xwj95/Atom/report/technical/src/package.tex

\usepackage{CJK}						%中日韩三国文字包
\usepackage{indentfirst}				%首段缩进包
\usepackage{amssymb}					%数学符号包
\usepackage{mathpazo}					%正文和数学字体包
\usepackage{geometry}					%页面设置包
\usepackage{graphicx}					%图片包
\usepackage{multirow}					%表格包
\usepackage{float}						%浮动包
\usepackage{tikz}						%流程图包
\usepackage{enumerate}					%标签包
\usepackage{cite}						%引用包
\usepackage[CJKbookmarks=true, colorlinks, linkcolor=black, anchorcolor=blue, citecolor=green]{hyperref}			%超链接包
\usepackage{longtable}					%长表格包

\setcounter{tocdepth}{5}
\setcounter{secnumdepth}{5}

\geometry{left=3cm, right=2.5cm, top=2.5cm, bottom=2.5cm}

\usetikzlibrary{shapes.geometric, arrows}

\renewcommand\arraystretch{1.5}
