xwj95/Atom/report/requirement/src/figure.tex

图片首先要转换为eps格式（请自行在网上找eps转换器）

 %中间的方括号用于设定图片大小，可选，大括号里是图片名字，图片大小除了用scale决定缩放比之外还可以通过width=1cm,height=2cm来指定规定大小，单位可以使用px,cm,inch等等

图片要放在同一目录下
