xwj95/Atom/report/requirement/src/table.tex

\clearpage

\begin{table}
\begin{tabular}{|c|c|c|c|c|c|c|c|c|c|c|c|c|c|c|c|c|}
\hline
\multirow{2}{*}{二进制（高位）} &
31&30&29&28&27&26&25&24&23&22&21&20&19&18&17&16\\
\cline{2-17}
&0&0&1&0&0&1&
\multicolumn{5}{c|}{rs}&
\multicolumn{5}{c|}{rt}\\
\hline
\multirow{2}{*}{二进制（低位）} &
15&14&13&12&11&10&9&8&7&6&5&4&3&2&1&0\\
\cline{2-17}
&
\multicolumn{16}{c|}{immediate}\\
\hline
MIPS语言&
\multicolumn{16}{l|}{ADDIU rt is immediate}\\
\hline
指令功能&
\multicolumn{16}{l|}{R[t] $\Leftarrow$ R[s] + Sign-extend(immediate)}\\
\hline
功能说明&
\multicolumn{16}{l|}{对立即数进行符号扩展后与寄存器rs的值求和，结果保存到寄存器rt中}\\
\hline
\end{tabular}
\end{table}

\begin{table}

\begin{tabular}{|c|c|c|c|c|c|c|c|c|c|c|c|c|c|c|c|c|}
\hline
\multirow{2}{*}{二进制（高位）} &
31&30&29&28&27&26&25&24&23&22&21&20&19&18&17&16\\
\cline{2-17}
&0&0&0&0&0&0&
\multicolumn{5}{c|}{rs}&
\multicolumn{5}{c|}{rt}\\
\hline
\multirow{2}{*}{二进制（低位）} &
15&14&13&12&11&10&9&8&7&6&5&4&3&2&1&0\\
\cline{2-17}
&
\multicolumn{5}{c|}{rd}&
0&0&0&0&0&1&0&0&0&0&1\\
\hline
MIPS语言&
\multicolumn{16}{l|}{ADDU rd rs rt}\\
\hline
指令功能&
\multicolumn{16}{l|}{R[d] $\Leftarrow$ R[s] + R[t]}\\
\hline
功能说明&
\multicolumn{16}{l|}{将寄存器rs与寄存器rt的值求和，结果保存到寄存器rd中}\\
\hline
\end{tabular}
\end{table}
\begin{table}
\begin{tabular}{|c|c|c|c|c|c|c|c|c|c|c|c|c|c|c|c|c|}
\hline
\multirow{2}{*}{二进制（高位）} &
31&30&29&28&27&26&25&24&23&22&21&20&19&18&17&16\\
\cline{2-17}
&0&0&0&0&0&0&
\multicolumn{5}{c|}{rs}&
\multicolumn{5}{c|}{rt}\\
\hline
\multirow{2}{*}{二进制（低位）} &
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
\cline{2-17}
&
\multicolumn{5}{c|}{rd} &
0&0&0&0&0&
0&0&0&0&0&
0\\
\hline
MIPS语言&
\multicolumn{16}{l|}{MFC0 rt rd}\\
\hline
指令功能&
\multicolumn{16}{l|}{R[t] $\Leftarrow$ CP0[R[d]]}\\
\hline
功能说明&
\multicolumn{16}{l|}{将协处理器0中的rd寄存器的值保存到rt寄存器中}\\
\hline
\end{tabular}
\end{table}

\begin{table}
\begin{tabular}{|c|c|c|c|c|c|c|c|c|c|c|c|c|c|c|c|c|}
\hline
\multirow{2}{*}{二进制（高位）} &
31&30&29&28&27&26&25&24&23&22&21&20&19&18&17&16\\
\cline{2-17}
&
0&1&0&0&0&
0&0&0&1&0&
0&
\multicolumn{5}{c|}{rt}\\
\hline
\multirow{2}{*}{二进制（低位）} &
15&14&13&12&11&10&9&8&7&6&5&4&3&2&1&0\\
\cline{2-17}
&
\multicolumn{5}{c|}{rd} &
0&0&0&0&0&
0&0&0&0&0&
0\\
\hline
MIPS语言&
\multicolumn{16}{l|}{MTC0 rd rt}\\
\hline
指令功能&
\multicolumn{16}{l|}{CP0[R[d]] $\Leftarrow$ R[t]}\\
\hline
功能说明&
\multicolumn{16}{l|}{将寄存器rt的值保存到协处理器0中的rd寄存器中}\\
\hline
\end{tabular}
\end{table}

\begin{table}
\begin{tabular}{|c|c|c|c|c|c|c|c|c|c|c|c|c|c|c|c|c|}
\hline
\multirow{2}{*}{二进制（高位）} &
31&30&29&28&27&26&25&24&23&22&21&20&19&18&17&16\\
\cline{2-17}
&
0&1&0&0&0&
0&1&0&0&0&
0&0&0&0&0&
0\\
\hline
\multirow{2}{*}{二进制（低位）} &
15&14&13&12&11&10&9&8&7&6&5&4&3&2&1&0\\
\cline{2-17}
&
0&0&0&0&0&
0&0&0&0&0&
0&0&0&0&1&
0\\
\hline
MIPS语言&
\multicolumn{16}{l|}{TLBWI}\\
\hline
指令功能&
\multicolumn{16}{l|}{R[d] $\Leftarrow$ R[t] $\ll$ R[s]}\\
\hline
功能说明&
\multicolumn{16}{l|}{写索引TLB项}\\
\hline
\end{tabular}
\end{table}

\begin{table}
\begin{tabular}{|c|c|c|c|c|c|c|c|c|c|c|c|c|c|c|c|c|}
\hline
\multirow{2}{*}{二进制（高位）} &
31&30&29&28&27&26&25&24&23&22&21&20&19&18&17&16\\
\cline{2-17}
&
1&0&0&1&0&
1&
\multicolumn{5}{c|}{rs}&
\multicolumn{5}{c|}{rt}\\
\hline
\multirow{2}{*}{二进制（低位）} &
15&14&13&12&11&10&9&8&7&6&5&4&3&2&1&0\\
\cline{2-17}
&
\multicolumn{16}{c|}{immediate}\\
\hline
MIPS语言&
\multicolumn{16}{l|}{LHU rt rs immediate}\\
\hline
指令功能&
\multicolumn{16}{l|}{R[t] $\Leftarrow$ Zero-extend(MEM$\_$HALFWORD[R[s] + Sign-extend(immediate)])}\\
\hline
\multirow{2}{*}{功能说明}&
\multicolumn{16}{l|}{将寄存器rt中的值与立即数immediate符号扩展后相加所得地址中的低两个}\\
&\multicolumn{16}{l|}{字节取出来零扩展后保存在寄存器rt中}\\
\hline
\end{tabular}
\end{table}
