xwj95/Atom/report/technical/src/title.tex

\title{32位MIPS综合实验设计文档}		%标题
\author{原子小组}						%作者
\maketitle							%显示标题、作者和日期
\tableofcontents					%目录
