xwj95/Atom/report/requirement/src/part5.tex

\section{附录}
\subsection{指令系统}
\input{table.tex}
