xwj95/Atom/report/requirement/requirement.pdf

# 32位MIPS综合实验需求文档

### 原子小组

### January 1, 2016

目 | 录
1 引言 | 2
2 功能需求 | 4
3 性能需求 | 13
4 运行环境需求 | 13
5 附录 | 14

## 1 引言

### 1.1 编写目的

撰写本篇需求文档的目的如下：

1. 明确项目需求，对该系统进行一个能够达成一致认可的描述，明确需要完成的功能；
2. 明确开发资源与项目目标；
3. 控制整个开发过程，作为开发手册的一部分，降低开发中小组讨论的成本。

文档预期读者包括开发人员、任务提出者及其他使用该资源的用户。

### 1.2 背景

本项目的系统名称为32位MIPS处理器。
本项目任务由计算机组成原理课程刘卫东老师、李山山老师和软件工程课程白晓颖老师共同提出。 承担本项目的开发者为计33班的徐炜杰、王楠和黄欢。此外还受到了刘卫东、白晓颖、李山山三位老 师的指导和王钧奕、张乐、刘亚宁三位助教的帮助。

### 1.3 定义

本段中给出了需求文档中对于一些术语的基本定义，具体如下。

表 1: 定义列表
术语 | 描述
RISC | Reduced Instruction Set Computer的缩写，指精简CPU指令集
MIPS | Microprocessor without Interlocked piped stages的缩写，指无内部互锁流水级的微 处理器，为一种典型RISC指令集
CPU | 中央处理器，为本项目的最终目标
CP0 | 系统控制协处理器，是CPU和操作系统交互的窗口；CPU通过CP0向操作系统传递运 行信息和异常信息等，而操作系统则通过操作CP0设置硬件的运行状态
MMU | 内存管理单元，负责对虚拟地址进行映射，并总管访问各种存储器和输入输出接口的 功能
TLB | 传输后备缓冲器（快表），即页表的高速缓存，用于加快地址转换。本项目需对内存 进行分页管理，即虚拟地址通过页表映射得到物理地址。
ALU | 算术逻辑单元
RAM | 存储程序的硬件，断电不保存信息，速度较快，常用于电脑主存储器
ROM | 存储程序的硬件，断电可保存信息
Flash | 存储程序的硬件，断电可保存信息，实验中用作硬盘
BIOS | 主板上的启动程序，负责初始化硬件引导操作系统
BootLoader | 由BIOS启动的一段特殊程序，用于将操作系统从Flash中加载到内存中，并且跳转到 开始地址执行
Controller | CPU模块之一，根据指令和硬件反馈信息给出控制信号，控制各个部件和整个CPU 的运行
组合逻辑元件 | 与运行时钟无关的元件，某一时刻的输出只取决于当前输入
时序逻辑元件 | 根据系统的时钟信号，在时钟的上升沿工作的元件。某一时刻的稳定输出由当前输入 和历史状态共同决定。注意组合逻辑元件和时序逻辑元件往往没有明确的分界；一个 寄存器往往仅在上升沿写入，但却随时按照组合逻辑方式将其内容进行输出

### 1.4 参考资料

1. 实验指导文档
2. OSLab实验参考文档
3. 贾开, 周昕宇, 李铁铮, 等. 计算机组成原理综合实验报告
4. 逆光组. 清华大学计算机组成原理32位Mips CPU教程
5. 刘卫东, 李山山, 宋佳兴, 等. 计算机硬件系统实验教程[M]. 清华大学出版社, 2013.
6. 帕特森, 亨尼斯, 康继昌, 等. 计算机组成与设计: 硬件/软件接口[M]. 机械工业出版社, 2012.
7. Sweetman D. See MIPS run[M]. Morgan Kaufmann, 2010.
8. 雷思磊. 自己动手写CPU[M]. 电子工业出版社, 2014.

## 2 功能需求

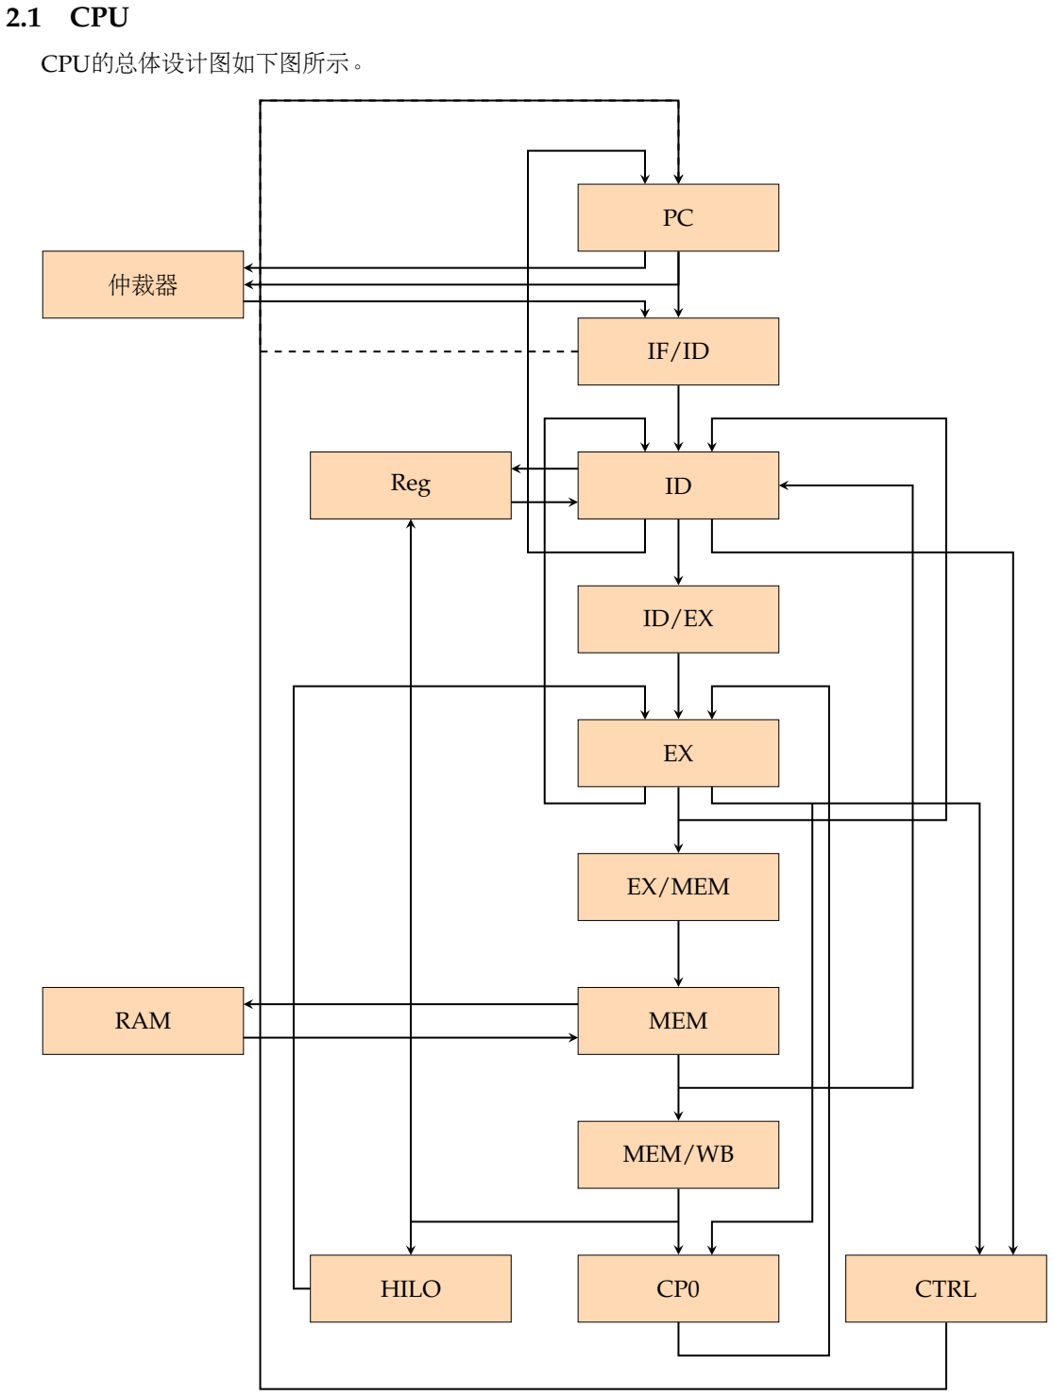
[picture p13: figure]
2.1 CPU; CPU的总体设计图如下图所示。; 仲裁器; Reg; EX/MEM; RAM; MEM; MEM/WB; HILO; CTRL

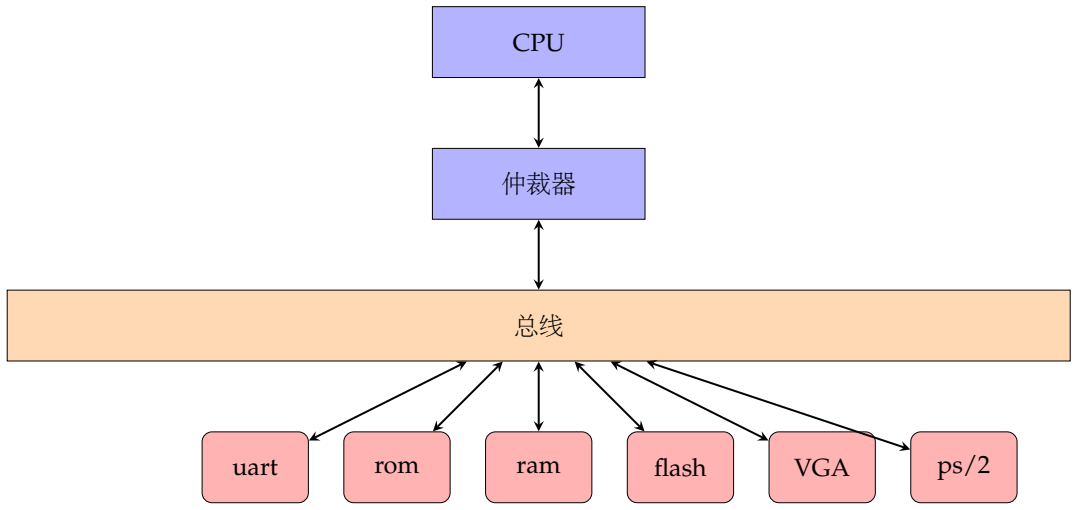
[picture p14: figure]
CPU; 仲裁器; uart; rom; ram; flash; VGA

### 2.1.1 ALU

算术逻辑单元负责实现双输入的算术、逻辑和移位运算功能，其中包括乘法运算。 算术逻辑单元的输入端为两个32位整数和一个8位操作码，输出端为32位整数（乘法运算除外），并 给出相应的标志位。
由于算术逻辑单元需要实现的运算种类较多，我们在此不做列举。

### 2.1.2 乘法器

乘法器负责实现乘法功能，输入为两个32位整数，输出为一个64位整数，分别存放在LO和HI两 个32位寄存器中。
乘法运算采用Verilog语言提供的乘法运算符实现。我们没有将乘法器作为一个独立的元件来实现，而 是在ALU中加入乘法的操作码，将乘法器并入算术逻辑单元实现。

### 2.1.3 寄存器堆

寄存器堆负责实现通用寄存器的读写和在数据通路中的控制，在流水线译码阶段读取一个或两个通用 寄存器的数据（组合逻辑电路），并在流水线写回阶段将结果写入通用寄存器（时序逻辑电路）。 32位MIPS架构需要实现32个32位通用寄存器，寄存器堆采用FPGA的逻辑单元来实现数据的存储，因 此读写速度比内存快。

### 2.1.4 CP0

32位MIPS架构支持4个协处理器，本次实验需要实现CP0协处理器。CP0协处理器可以实现对TLB、MMU及 异常处理的管理机制。
下表列出了CP0的寄存器及其功能，这里我们只给出必须实现的11个寄存器。

编号 | 寄存器名称 | 寄存器功能
0 | Index | 用于TLBWI指令访问TLB入口的索引序号
2 | EntryLo0 | 作为TLBWI及其他TLB指令接口，管理偶数页入口
3 | EntryLo1 | 作为TLBWI及其他TLB指令接口，管理奇数页入口
9 | BadVAddr | 捕捉最近一次地址错误或TLB异常（重填、失效、修改）时的虚拟地址
10 | Count | 每隔一个时钟增加1，用作计数器，并可使能控制
11 | EntryHi | TLB异常时，系统将虚拟地址部分写入EntryHi寄存器中用于TLB匹配信息
12 | Compare | 保持一定值，当Count值与Compare相等时，SI TimerInt引脚变高电平直到有数

值写入Compare，用于定时中断

13 | Status | 表示处理器的操作模式、中断使能及诊断状态
15 | Cause | 记录最近一次异常的原因，控制软件中断请求以及中断处理派分的向量
16 | EPC | 存储异常处理之后程序恢复执行的地址
18 | EBase | 识别多处理器系统中不同的处理器异常向量的基地址
(1) Index寄存器 Index寄存器是一个32位读/写寄存器，可用于TLBP、TLBR和TLBWI指令访问TLB入口 的索引序号。
Index区域的大小根据具体实现方式随TLB的入口个数而定。对于基于TLB的内存管理单元MMU来 说，该区域的最小值为dlog2(TLBEntries)e。 如果一个写入Index寄存器的值大于等于TLB入口数，则该处理器的操作是未定义的。 该寄存器仅对TLB有效。
31 | 30 | 6 | 5 | 0
P | 0 | Index
区域 | 描述 | 读/写 | 重置状态
名称 | 比特
P | 31 | 检测故障。当先前的TLBProbe（TLBP）指令没有在TLB中寻 得匹配时，硬件会将其置为1。 | R/W | 未定义
0 | 30:6 | 必须写为0；读取时返回0. | 0 | 0
Index | 5:0 | TLB入口的索引值，收到TLBRead和TLBWrite指令影响。 对于16或32个入口的TLB，如果索引指向一个不存在的入口， 则该行为是未定义的。 | R/W | 未定义
(2) EntryLo1/EntryLo0寄存器 这对EntryLo寄存器的作用等同于TLB、TLBR、TLBWI和TLBWR指令间 的接口。对基于TLB的MMU而言，EntryLo0管理偶数页的入口，EntryLo1管理奇数页的入口。如果 出现了地址错误，TLB失效，TLB修改或是TLB重填异常的行为，那么EntryLo0和EntryLo1寄存器的 内容将会成为未定义的。只有当基于TLB的存储管理单元存在时，这些寄存器才有效。
31 | 30 | 29 | 26 | 25 | 6 | 5 | 3 | 2 | 1 | 0
R | O | PFN | C | D | V | G

区域 | 描述 | 读/写 | 重置状态
名称 | 比特
R | 31:30 | 保留区域。写入时应被忽略；读取时返回0. | R | 0
O | 29:26 | 在一般情况下，这4个位为PFN的一部分。但由 于24k仅支持32位的物理地址，PFN仅有20位 的位宽，所以，该寄存器的29:26位强制写入0. | R | 0
PFN | 25:6 | 页帧号：有助于物理地址高位的定义。PFN区域 对应了物理地址的31 12位。 | R/W | 未定义
C | 5:3 | 页面一致性属性。 | R/W | 未定义
D | 2 | 已使用或写使能位：表示了该页面已经被写入，并且 /或者是可写入的。如果D=1，则允许写入该页；如果 D=0，则不允许写入该页，否则会引起TLB修改异常。 | R/W | 未定义
V | 1 | 有效位：指明当前TLB入口是否有效，即虚拟页面映 射是否有效。如果该位为1，那么允许进入该页；如 果V=1，则允许访问该页；如果V=0，访问该页会引 起TLB无效异常。 | R/W | 未定义
G | 0 | 全局位：在对TLB入口进行写操作时，EntryLo0和 EntryLo1寄存器中的G位与运算的结果作为TLB入 口的G位。如果TLB入口的G位时1，ASID比较将在 TLB匹配中被忽略掉。在对TLB入口进行读操作时， EntryLo0和EntryLo1的G位都反映了TLB的G位的状态。 | R/W | 未定义
C[5:3]值 | 缓存一致性属性
0 | 可缓存、非一致性、写通、无写分配
1 | 保留
2 | 不可缓存
3 | 缓存可、非一致性、写回、写分配
4,5,6 | 保留
7 | 无缓存加速
(3) EntryHi寄存器 EntryHi寄存器包含了用于TLB读、写和访问操作的虚拟地址匹配信息。当TLB异常 （TLB Refill，TLB Invalid或TLB Modified）发生时，系统将虚拟地址的[31:13]位写入EntryHi寄存 器的VPN2区域。TLBR指令将选中的TLB入口相应的区域写入EntryHi寄存器。软件（通常是操作系 统）将当前地址空间标识符写入ASID区域，该区域在TLB比较过程中用于确定TLB是否可以匹配。 由于ASID区域被TLBR指令重填覆盖了，软件必须保存和重新存储有关TLBR使用的ASID的值。这在 发生TLB失效和TLB修改异常时，以及在其它存储管理软件中尤为重要。 在发生了地址错误的异常后，EntryHi寄存器的VPN2区域将成为未定义的，并且该区域可能在 发生地址错误异常的过程中被硬件修改。EntryHi寄存器的软件写操作（通过MTC0）不会导

致BadVAddr和Context寄存器中的地址相关区域发生隐式的写入（implicit write）。

31 | 13 | 12 | 8 | 7 | 0
VPN2 | 0 | ASID
区域 | 描述 | 读/写 | 重置状态
名称 | 比特
VPN2 | 31..13 | 虚地址（虚拟页面数目的一半）的VA31..13。在TLB异常 或TLB进行读取时，该区域被硬件写入；在TLB写之前， 该区域被软件写入。 | R/W | 未定义
0 | 12..8 | 必须写为0；在读取时返回0. | 0 | 0
ASID | 7..0 | 地址空间标识符。在TLB读取时，该区域由硬件写入；通过 软件写该区域，可以为TLB写操作建立当前的ASID值，这 样可以避免对TLB的访问匹配所有TLB入口的ASID值。 | R/W | 未定义

该寄存器仅对TLB有效。

(4) Status寄存器 Status寄存器是一个读/写寄存器，可以表示处理器的操作模式、中断使能以及诊断状 态。该寄存器的区域联合作用，可以创建处理器的工作模式。 中断使能：当以下所有条件成立时启用中断：
Status[0]:IE = 1
Status[0]:EXL = 0
Status[0]:ERL = 0
额外的：Debug[0]:DM = 0
当这些条件都符合时，设置IM（Status[16:9]）位和IE位可以使能中断。 EXL与ERL任一位置1都可使系统进入Kernel模式，否则为User模式。
(5) Cause寄存器 Cause寄存器主要记录最近一次异常的原因，也控制软件中断请求以及中断处理派分的 向量。除了IP1..0、DC、IV和WP区域，Cause寄存器中其它的所有区域都是只读的。第二版架构在 外部中断控制器（EIC）的中断模式下，增加了可选项。在这个模式下，IP7..2表示请求中断优先级 （RIPL）。
Cause[6:2]表示ExcCode，即异常号。
(6) Ebase寄存器 EBase寄存器是一个读/写寄存器，包含了在StatusBEV为0时所使用的异常向量的基地 址及一个只读CPU号，该CPU号可以被软件用来区分多处理器系统中不同的处理器。 EBase寄存器使软件能在多处理器系统中识别特定的处理器，并允许每个处理器的异常向量可以不 同，特别是对由多种处理器组成的系统。当StatusBEV为0时，EBase寄存器的位31:12由0构成，形成 异常向量的基地址。当StatusBEV为1时，或在任何EJTAG调试异常的情况下，异常向量的基地址由 固定的缺省值确定。
EBase寄存器的位31:30固定为2#10，从而强制异常基地址在kseg0或kseg1的无映射的虚拟地址段中。 在缓存错误异常中，异常基地址的位29将被强制置为1，从而使异常处理器从无缓存的kseg1段开 始执行。如果需要改变异常基地址寄存器的值，则操作必须在StatusBEV为1的情况下进行。如果 在StatusBEV为0时，在异常基地址区域写入了一个不同的值，处理器的操作将成为未定义的。 将位31:12与异常基地址区域相结合，可允许将异常向量的基地址置于任何4KB字节大小的页面的边界 上。

31 | 30 | 29 | 12 | 11 | 10 | 9 | 0
1 | 0 | Exception Base | 0 | CPUNum
区域 | 描述 | 读/写 | 重置状态
名称 | 比特
1 | 31 | 在写入时，该位被忽略；在读取时，返回0. | R | 1
Exception | 29:12 | 与位31:30结合，该区域在StatusSEV为0时，指定了 异常的基地址。 | R/W | 0
CPUNum | 9:0 | 该区域包含了一个标识符，它对多处理器系统的每个 CPU都是唯一的。软件可以用此来判断它运行的位置。 这个区域的值由连接到内核的SI CPUNum[9 : 0]静态 输入管脚设置。 | R | 外部设置
0 | 30, 11:10 | 必须写为0；在读取时返回0. | 0 | 0

通过调用MFC0，MTC0指令，CP0提供了统一的对外接口以完成对寄存器组的访问。

实现步骤：

(1) 选择要实现的CP0寄存器，可考虑推荐实现的寄存器或自行决定额外寄存器实现。
(2) 按照CP0寄存器的功能分别在CPU的不同模块完成各寄存器的赋值。
(a) 在译码、运算及访存阶段发生地址错误时将错误地址赋值给BadVAddr
(b) 异常处理开始时，若为TLB异常，则将错误地址高20位赋值给EntryHi高20位
(c) 异常处理开始时，将Status[1]赋值为1；在执行ERET指令时将Status[1]赋值为0
(d) 异常处理开始时，将Cause[6:2]赋值为异常号
(e) 异常处理开始时，将EPC赋值为Victim指令地址
(f) 每个周期，Count加1
(g) 其他写操作由软件完成
(3) 实现MFC0，MTC0指令访问CP0寄存器的功能。
(4) 通过各寄存器值控制相应功能。

### 2.1.5 异常中断处理

本次实验要求实现精确异常处理，即确定异常发生的位置，确保该指令前的指令全部执行完毕，并将 该指令后的指令从流水线上擦除。
以下是一些可能用到的中断和异常的情况。

异常号 | 异常名 | 描述
0 | Interrupt | 外部中断、异步发生，由硬件引起
1 | TLB Modified | 内存修改异常，发生在Memory阶段
2 | TLBL | 读未在TLB中映射的内存地址触发的异常
3 | TLBS | 写未在TLB中映射的内存地址触发的异常
4 | ADEL | 读访问一个非对齐地址触发的异常
5 | ADES | 写访问一个非对齐地址触发的异常
8 | SYSCALL | 系统调用
10 | RI | 执行未定义指令异常
11 | Co-Processor Unavailable | 试图访问不存在的协处理器异常
23 | Watch | Watch寄存器监控异常

下表列出可能用到的中断号。

| 中断号 | 设备
| 0 | 系统计时器
| 1 | 键盘
| 3 | 通讯端口COM2
| 4 | 通讯端口COM1

中断/异常处理的一般流程如下：

(1) 保存中断信息，主要是EPC，BadVaddr，Status，Cause等寄存器的信息 EPC:存储异常处理之后程序恢复执行的地址。对于一般异常，当前发生错误的指令地址即 为EPC应当保存的地址；而对于硬件中断，由于是异步产生则可以任意设定一条并未执行完成的指令 地址保存，但在进入下一步处理之前，该指令前的指令都应当被执行完。 BadVAddr：捕捉最近一次地址错误或TLB异常（重填、失效、修改）时的虚拟地址。 Status：将EXL位置为1，进入kernel模式进行中断处理。
Cause：记录下异常号。
EntryHi：TLB异常时，记录下BadVAddr的部分高位。
(2) 根据Cause中的异常号跳转到相应的异常处理函数入口
(3) 中断处理
(4) 通过调用ERET指令恢复现场，返回EPC所存地址执行并且将Status中的EXL重置为0表示进入user模 式。

实现步骤：

(1) 在可能发生异常的位置实现对异常的记录。
(a) 访存时可能发生ADEL，ADES，TLBM，TLBL，TLBS，Watch异常
(b) 译码后可能发生RI，SYSCALL，Co-ProcessorU异常

(2) 实现对中断的记录。
(a) 硬件产生中断时将信息写入CP0寄存器
(3) 根据异常记录信息判断是否产生异常。
(4) 进入异常处理流程。

### 2.1.6 MMU

内存管理单元负责实现虚拟地址转换到物理地址，再访问相应元件读取或写入数据的全过程，并实现 内核态与用户态的区分。同时MMU还需要集成TLB模块，并实现相应的TLB异常处理。

### 2.1.6.1 物理地址划分

物理地址范围 | 设备 | 说明
[0x00000000, 0x007FFFFF] | RAM | 共8MB
[0x1FC00000, 0x1FC00FFF] 引导ROM | 共4KB
[0x1E000000, 0x1EFFFFFF] flash | 地址空间共16MB，但对于32位字，只有低16位有效
[0x1A000000, 0x1A096000] | VGA
0x1FD003F8 | 串口数据
0x1FD003FC | 串口状态
0x1FD00400 | 数码管
0x0F000000 | 键盘码

### 2.1.6.2 虚拟地址划分

虚拟地址范围 | 名称 | 权限 | MMU | 物理地址范围
[0x00000000, 0x7FFFFFFF] | kuseg | 内核/用户 | 是 | -
[0x80000000, 0x9FFFFFFF] | kseg0 | 内核 | 否 | [0x00000000, 0x1FFFFFFF]
[0xA0000000, 0xBFFFFFFF] kseg1 | 内核 | 否 | [0x00000000, 0x1FFFFFFF]
[0xC0000000, 0xFFFFFFFF] | kseg2 | 内核 | 是 | -

### 2.1.6.3 TLB

虚拟地址到物理地址的转换是通过查找页表来实现的，为了加速查询过程，CPU对页表进行缓存。如 果虚拟地址在页表中没有找到相应的映射，将产生缺页异常，由操作系统将对应的页表项加入缓存，并 继续进行访问操作。
本实验中硬件需要实现一组寄存器来存储页表的缓存，支持TLBWI语句，并和CP0协处理器配合工 作，页表的管理和异常处理等则由软件实现。
TLB共有16个表项，每个表项有64位长，每项可以存储两个物理页，因此总共可以存储32个页。 每次页表项更新时，页表信息被存放在如下寄存器中：目录为INDEX [3 : 0]，对应的每个表项入口为 {EntryHi [31 : 13] , EntryLo1 [25 : 6] , EntryLo1 [2 : 1] , EntryLo0 [25 : 6] , EntryLo0 [2 : 1]} 即高22位存储了虚拟地址高22位，后面分别跟着两组物理地址（奇偶）及其标志位（Valid，Global）， 匹配虚拟地址与标志后将实地址合并得到物理地址。

### 2.2 Ucore

### 2.2.1 BIOS

BIOS即为启动ucore所用的Bootloader程序，通常是放在Flash中。本实验中我们将在FPGA里建立 一块ROM，将Bootloader放置在该ROM中，并且设置CPU的访问地址从该ROM开始，这样能避免由 于Flash的读写不稳定而对BIOS造成的破坏，还能将ucore与BIOS独立出来。 BIOS启动时，Flash中的操作系统加载到内存中，然后跳转到操作系统的初始化代码，从而开始操作 系统的工作。

### 2.2.2 远程文件执行

修改ucore，实现简单的远程文件执行功能，即通过串口从PC上获取ELF文件，并在本地执行。

### 2.3 外设

### 2.3.1 串口

串口的功能需求为实现与PC机的通信，通过计算机键盘输入数据，向计算机输出数据。 串口模块波特率固定在115200，数据位8位，停止位1位，无校验。 地址1FD003F8表示数据（仅低8位有效），必须使用SW命令写入。 地址1FD003FC表示状态寄存器Status，Status&1=1时可写，Status&2=2时可读。

### 2.3.2 VGA

Device VGA模块是显示控制模块，接受CPU写入的ASCII码数据，并维护一个字符矩阵，以字符中 断的形式通过VGA接口输出到显示器。
CPU需要从地址1FC03000读出数据，如果结果为‘1’表示可以写入，否则不能写入。可以写入时， 向该地址写入ASCII数据即可。
显示模块包含两个子模块：控制模块DisplayControl以及VGA模块VGA640480。 屏幕分辨率640*480，VGA时钟为25MHz。
屏幕划分为若干个8*16的小方格，方格总数为80*30。 为了能够显示所有ASCII码字符，事先生成了ASCII码对应的8*16点阵，存储在一块片上ROM里， 由VGA640480模块调用。
DisplayControl模块内使用一块片上Ram存储80*30个方格对应的ASCII码，并由VGA640480模块调用 进行查询。此外，DisplayControl模块接收外部给出的写信号，对字符进行写入。

### 2.3.3 ps/2键盘

Device Keyboard模块位键盘控制模块。从地址0F000000读出数据，结果为0表示没有新数据，否则 读到的就是键入的ASCII码。
PS/2键盘读到的是扫描码，为了方便软件，可以在硬件层面加入编码转换，CPU读到的直接就 是ASCII码。

### 2.4 数据通路

本实验将实现基于标准32位MIPS指令集的子集的五级流水CPU，支持异常、中断、TLB等。 MIPS指令集的各条指令可以分解为取指（IF）、译码（ID）、执行（EX）、访存（MEM）和回写 （WB）五个阶段，分别对应于本次实验需要实现的五个核心模块。模块内部采用组合逻辑电路实现，相 邻模块之间的数据传输采用时序逻辑电路实现，每经过一个时钟周期，所有阶段分别将各自保存的结果 交给下一个阶段，从而实现流水CPU。
此外，我们还需要实现寄存器堆模块（Regfile）、HILO模块（HILO）、协处理器模块（CP0）和 控制模块（CTRL）。寄存器堆模块在译码阶段实现，便于指令在译码阶段访问寄存器并得到相应的数 据。HILO模块和协处理器模块在回写阶段实现。控制模块则用于控制整个流水线的暂停、清除等动作， 因此不将其归入流水线中的某一个阶段。

流水线虽然能提高指令执行效率，但由此带来的冲突是不可避免的。流水线冲突主要有结构冲突、数 据冲突和控制冲突三种类型。

1. 结构冲突
指令在重叠执行过程中发生硬件资源冲突，在MIPS架构中主要是指取指阶段和访存阶段同时对存 储器进行访问引起的冲突。解决方法是在设计数据通路时，添加仲裁器，根据仲裁器状态决定此时 存储器进行取值还是访存。
2. 数据冲突
在同时重叠执行的几条指令中，一条指令依赖于前面指令执行结果，但是得不到执行结果造成的冲 突。解决方法是在数据通路中加入流水线暂停和恢复机制，并引入数据前推技术，将执行结果提前 送到其他模块，以供其他模块参考和使用。
3. 控制冲突
流水线中的分支指令或者其他需要改写PC的指令造成的冲突。解决方法是引入延时槽机制，这要 求编译器在分支指令后插入空指令，对流水线的性能有一定的影响。

本次实验需要实现的MIPS32指令集详见附录，基本数据通路图详见设计文档。

## 3 性能需求

实现流水线CPU，通过良好的内部设计使流水线各阶段的用时相当，以减少因某些指令带来整体延迟 的情况。
针对流水线CPU的开发目标，本项目的主频目标暂定为12.5MHz。

## 4 运行环境需求

### 4.1 设备

在硬件上提供了一块开发板，主要核心部件为Xilinx Spartan6 xc6slx100 FPGA。

表 2: 设备与外部接口
环境 | 描述
FPGA | Xilinx Spartan6 xc6slx100
RAM | 32-bit字长，4块，共8MB
Flash | 16-bit字长，共8MB
CPLD | 与FPGA相连，用于I/O
串口 | 2个
ps/2接口 | 1个
以太网接口 | 1个
VGA接口 | 1个

### 4.2 控制

本工程将会充分利用开发板资源，控制部分采用键盘作为输入设备，PVGA显示作为输出，从终端通 过串口和网口实现PC和开发板的双向通信和数据交流。如果有需要，也可以启用开发板上的第二个串 口。

## 5 附录

### 5.1 指令系统

二进制（高位） | 31 | 30 | 29 | 28 | 27 | 26 | 25 | 24 | 23 | 22 | 21 | 20 | 19 | 18 | 17 | 16
| 0 | 0 | 1 | 0 | 0 | 1 | rs | | | | | rt
二进制（低位） | 15 | 14 | 13 | 12 | 11 | 10 | 9 | 8 | 7 | 6 | 5 | 4 | 3 | 2 | 1 | 0

immediate
MIPS语言 | ADDIU rt is immediate
指令功能 | R[t] ⇐ R[s] + Sign-extend(immediate)
功能说明 | 对立即数进行符号扩展后与寄存器rs的值求和，结果保存到寄存器rt中
二进制（高位） | 31 | 30 | 29 | 28 | 27 | 26 | 25 | 24 | 23 | 22 | 21 | 20 | 19 | 18 | 17 | 16
| 0 | 0 | 0 | 0 | 0 | 0 | rs | | | | | rt
二进制（低位） | 15 | 14 | 13 | 12 | 11 | 10 | 9 | 8 | 7 | 6 | 5 | 4 | 3 | 2 | 1 | 0
| rd | | | | | 0 | 0 | 0 | 0 | 0 | 1 | 0 | 0 | 0 | 0 | 1
MIPS语言 | ADDU rd rs rt
指令功能 | R[d] ⇐ R[s] + R[t]
功能说明 | 将寄存器rs与寄存器rt的值求和，结果保存到寄存器rd中
二进制（高位） | 31 | 30 | 29 | 28 | 27 | 26 | 25 | 24 | 23 | 22 | 21 | 20 | 19 | 18 | 17 | 16
| 0 | 0 | 0 | 0 | 0 | 0 | rs | | | | | rt
二进制（低位） | 15 | 14 | 13 | 12 | 11 | 10 | 9 | 8 | 7 | 6 | 5 | 4 | 3 | 2 | 1 | 0
| rd | | | | | 0 | 0 | 0 | 0 | 0 | 1 | 0 | 1 | 0 | 1 | 0
MIPS语言 | SLT rd rs rt
指令功能 | if(R[s] < R[t]) then R[d] = 1, else R[d] = 0
功能说明 | 比较寄存器rs与寄存器rt的值并根据结果对寄存器rd赋值
二进制（高位） | 31 | 30 | 29 | 28 | 27 | 26 | 25 | 24 | 23 | 22 | 21 | 20 | 19 | 18 | 17 | 16
| 0 | 0 | 1 | 0 | 1 | 0 | rs | | | | | rt
二进制（低位） | 15 | 14 | 13 | 12 | 11 | 10 | 9 | 8 | 7 | 6 | 5 | 4 | 3 | 2 | 1 | 0

immediate
MIPS语言 | SLTI rt rs immediate
指令功能 | if(R[s] < Sign-extend(immediate)) R[t] = 1, else R[t] = 0
功能说明 | 比较寄存器rs与立即数进行符号扩展后的值并根据结果对寄存器rt赋值

二进制（高位） | 31 | 30 | 29 | 28 | 27 | 26 | 25 | 24 | 23 | 22 | 21 | 20 | 19 | 18 | 17 | 16
| 0 | 0 | 1 | 0 | 1 | 1 | rs | | | | | rt
二进制（低位） | 15 | 14 | 13 | 12 | 11 | 10 | 9 | 8 | 7 | 6 | 5 | 4 | 3 | 2 | 1 | 0

immediate
MIPS语言 | SLTIU rt rs immediate
指令功能 | if(R[s] < Zero-extend(immediate)) R[t] = 1, else R[t] = 0
功能说明 | 比较寄存器rs与立即数进行零扩展后的值并根据结果对寄存器rt赋值
二进制（高位） | 31 | 30 | 29 | 28 | 27 | 26 | 25 | 24 | 23 | 22 | 21 | 20 | 19 | 18 | 17 | 16
| 0 | 0 | 0 | 0 | 0 | 0 | rs | | | | | rt
二进制（低位） | 15 | 14 | 13 | 12 | 11 | 10 | 9 | 8 | 7 | 6 | 5 | 4 | 3 | 2 | 1 | 0
| rd | | | | | 0 | 0 | 0 | 0 | 0 | 1 | 0 | 1 | 0 | 1 | 1
MIPS语言 | SLTU rd rs rt
指令功能 | if(R[s] < R[t]) R[d] = 1, else R[d] = 0
功能说明 | 比较寄存器rs与寄存器rt的值并根据结果对寄存器rd赋值
二进制（高位） | 31 | 30 | 29 | 28 | 27 | 26 | 25 | 24 | 23 | 22 | 21 | 20 | 19 | 18 | 17 | 16
| 0 | 0 | 0 | 0 | 0 | 0 | rs | | | | | rt
二进制（低位） | 15 | 14 | 13 | 12 | 11 | 10 | 9 | 8 | 7 | 6 | 5 | 4 | 3 | 2 | 1 | 0
| rd | | | | | 0 | 0 | 0 | 0 | 0 | 1 | 0 | 0 | 0 | 1 | 1
MIPS语言 | SUBU rd rs rt
指令功能 | R[d] ⇐ R[s] - R[t]
功能说明 | 用寄存器rs的值减寄存器rt的值，结果保存到寄存器rd中
二进制（高位） | 31 | 30 | 29 | 28 | 27 | 26 | 25 | 24 | 23 | 22 | 21 | 20 | 19 | 18 | 17 | 16
| 0 | 0 | 0 | 0 | 0 | 0 | rs | | | | | rt
二进制（低位） | 15 | 14 | 13 | 12 | 11 | 10 | 9 | 8 | 7 | 6 | 5 | 4 | 3 | 2 | 1 | 0
| 0 | 0 | 0 | 0 | 0 | 0 | 0 | 0 | 0 | 0 | 0 | 1 | 1 | 0 | 0 | 0
MIPS语言 | MULT rs rt
指令功能 | HI/LO ⇐ R[s] * R[t]
功能说明 | 将寄存器rs与寄存器rt的值相乘，保存到寄存器HI/LO中

二进制（高位） | 31 | 30 | 29 | 28 | 27 | 26 | 25 | 24 | 23 | 22 | 21 | 20 | 19 | 18 | 17 | 16
| 0 | 0 | 0 | 0 | 0 | 0 | 0 | 0 | 0 | 0 | 0 | 0 | 0 | 0 | 0 | 0
二进制（低位） | 15 | 14 | 13 | 12 | 11 | 10 | 9 | 8 | 7 | 6 | 5 | 4 | 3 | 2 | 1 | 0
| rd | | | | | 0 | 0 | 0 | 0 | 0 | 0 | 1 | 0 | 0 | 1 | 0
MIPS语言 | MFLO rd
指令功能 | R[d] ⇐ LO
功能说明 | 将LO寄存器的值保存到rd寄存器中
二进制（高位） | 31 | 30 | 29 | 28 | 27 | 26 | 25 | 24 | 23 | 22 | 21 | 20 | 19 | 18 | 17 | 16
| 0 | 0 | 0 | 0 | 0 | 0 | 0 | 0 | 0 | 0 | 0 | 0 | 0 | 0 | 0 | 0
二进制（低位） | 15 | 14 | 13 | 12 | 11 | 10 | 9 | 8 | 7 | 6 | 5 | 4 | 3 | 2 | 1 | 0
| rd | | | | | 0 | 0 | 0 | 0 | 0 | 0 | 1 | 0 | 0 | 0 | 0
MIPS语言 | MFHI rd
指令功能 | R[d] ⇐ HI
功能说明 | 将HI寄存器的值保存到rd寄存器中
二进制（高位） | 31 | 30 | 29 | 28 | 27 | 26 | 25 | 24 | 23 | 22 | 21 | 20 | 19 | 18 | 17 | 16
| 0 | 0 | 0 | 0 | 0 | 0 | rs | | | | | 0 | 0 | 0 | 0 | 0
二进制（低位） | 15 | 14 | 13 | 12 | 11 | 10 | 9 | 8 | 7 | 6 | 5 | 4 | 3 | 2 | 1 | 0
| 0 | 0 | 0 | 0 | 0 | 0 | 0 | 0 | 0 | 0 | 0 | 1 | 0 | 0 | 1 | 1
MIPS语言 | MTLO rs
指令功能 | LO ⇐ R[s]
功能说明 | 将寄存器rs的值保存到LO寄存器中
二进制（高位） | 31 | 30 | 29 | 28 | 27 | 26 | 25 | 24 | 23 | 22 | 21 | 20 | 19 | 18 | 17 | 16
| 0 | 0 | 0 | 0 | 0 | 0 | rs | | | | | 0 | 0 | 0 | 0 | 0
二进制（低位） | 15 | 14 | 13 | 12 | 11 | 10 | 9 | 8 | 7 | 6 | 5 | 4 | 3 | 2 | 1 | 0
| 0 | 0 | 0 | 0 | 0 | 0 | 0 | 0 | 0 | 0 | 0 | 1 | 0 | 0 | 0 | 1
MIPS语言 | MTHI rs
指令功能 | HI ⇐ R[s]
功能说明 | 将寄存器rs的值保存到HI寄存器中

二进制（高位） | 31 | 30 | 29 | 28 | 27 | 26 | 25 | 24 | 23 | 22 | 21 | 20 | 19 | 18 | 17 | 16
| 0 | 0 | 0 | 1 | 0 | 0 | rs | | | | | rt
二进制（低位） | 15 | 14 | 13 | 12 | 11 | 10 | 9 | 8 | 7 | 6 | 5 | 4 | 3 | 2 | 1 | 0

immediate
MIPS语言 | BEQ rs rt immediate
指令功能 | if(R[s] = R[t]) PC ⇐ PC + Sign-extend(immediate)
功能说明 | 如果寄存器rs与寄存器rt的值相等，则跳转到目的地址执行，否则顺序执行下 一条指令
二进制（高位） | 31 | 30 | 29 | 28 | 27 | 26 | 25 | 24 | 23 | 22 | 21 | 20 | 19 | 18 | 17 | 16
| 0 | 0 | 0 | 0 | 0 | 1 | rs | | | | | 0 | 0 | 0 | 0 | 1
二进制（低位） | 15 | 14 | 13 | 12 | 11 | 10 | 9 | 8 | 7 | 6 | 5 | 4 | 3 | 2 | 1 | 0

immediate
MIPS语言 | BGEZ rs immediate
指令功能 | if(R[s] >= 0) PC ⇐ PC + Sign-extend(immediate)
功能说明 | 如果寄存器rs的值大于等于0，则跳转到目的地址执行，否则顺序执行下一条 指令
二进制（高位） | 31 | 30 | 29 | 28 | 27 | 26 | 25 | 24 | 23 | 22 | 21 | 20 | 19 | 18 | 17 | 16
| 0 | 0 | 0 | 1 | 1 | 1 | rs | | | | | 0 | 0 | 0 | 0 | 0
二进制（低位） | 15 | 14 | 13 | 12 | 11 | 10 | 9 | 8 | 7 | 6 | 5 | 4 | 3 | 2 | 1 | 0

immediate
MIPS语言 | BGTZ rs immediate
指令功能 | if(R[s] > 0) PC ⇐ PC + Sign-extend(immediate)
功能说明 | 如果寄存器rs的值大于0，则跳转到目的地址执行，否则顺序执行下一条指令
二进制（高位） | 31 | 30 | 29 | 28 | 27 | 26 | 25 | 24 | 23 | 22 | 21 | 20 | 19 | 18 | 17 | 16
| 0 | 0 | 0 | 1 | 1 | 0 | rs | | | | | 0 | 0 | 0 | 0 | 0
二进制（低位） | 15 | 14 | 13 | 12 | 11 | 10 | 9 | 8 | 7 | 6 | 5 | 4 | 3 | 2 | 1 | 0

immediate
MIPS语言 | BLEZ rs
指令功能 | if(R[s] <= 0) PC ⇐ PC + Sign-extend(immediate)
功能说明 | 如果寄存器rs的值小于等于0，则跳转到目的地址执行，否则顺序执行下一条 指令

二进制（高位） | 31 | 30 | 29 | 28 | 27 | 26 | 25 | 24 | 23 | 22 | 21 | 20 | 19 | 18 | 17 | 16
| 0 | 0 | 0 | 0 | 0 | 1 | rs | | | | | 0 | 0 | 0 | 0 | 0
二进制（低位） | 15 | 14 | 13 | 12 | 11 | 10 | 9 | 8 | 7 | 6 | 5 | 4 | 3 | 2 | 1 | 0

immediate
MIPS语言 | BLTZ rs
指令功能 | if(R[s] < 0) PC ⇐ PC + Sign-extend(immediate)
功能说明 | 如果寄存器rs的值小于0，则跳转到目的地址执行，否则顺序执行下一条指令
二进制（高位） | 31 | 30 | 29 | 28 | 27 | 26 | 25 | 24 | 23 | 22 | 21 | 20 | 19 | 18 | 17 | 16
| 0 | 0 | 0 | 1 | 0 | 1 | rs | | | | | rt
二进制（低位） | 15 | 14 | 13 | 12 | 11 | 10 | 9 | 8 | 7 | 6 | 5 | 4 | 3 | 2 | 1 | 0

immediate
MIPS语言 | BNE rs rt
指令功能 | if(R[s] != R[t]) PC ⇐ PC + Sign-extend(immediate)
功能说明 | 如果寄存器rs与寄存器rt的值不相等，则跳转到目的地址执行，否则顺序执行 下一条指令
二进制（高位） | 31 | 30 | 29 | 28 | 27 | 26 | 25 | 24 | 23 | 22 | 21 | 20 | 19 | 18 | 17 | 16
| 0 | 0 | 0 | 0 | 1 | 0 | immediate(26bit)
二进制（低位） | 15 | 14 | 13 | 12 | 11 | 10 | 9 | 8 | 7 | 6 | 5 | 4 | 3 | 2 | 1 | 0

immediate(26bit)
MIPS语言 | J immediate
指令功能 | PC ⇐ PC + Sign-extend(immediate)
功能说明 | 无条件跳转目的地址执行
二进制（高位） | 31 | 30 | 29 | 28 | 27 | 26 | 25 | 24 | 23 | 22 | 21 | 20 | 19 | 18 | 17 | 16
| 0 | 0 | 0 | 0 | 1 | 1 | immediate(26bit)
二进制（低位） | 15 | 14 | 13 | 12 | 11 | 10 | 9 | 8 | 7 | 6 | 5 | 4 | 3 | 2 | 1 | 0

immediate(26bit)
MIPS语言 | JAL immediate
指令功能 | PC ⇐ PC + Sign-extend(immediate), RA ⇐ RPC
功能说明 | 无条件跳转目的地址执行，将延迟槽后一条指令存入RA

二进制（高位） | 31 | 30 | 29 | 28 | 27 | 26 | 25 | 24 | 23 | 22 | 21 | 20 | 19 | 18 | 17 | 16
| 0 | 0 | 0 | 0 | 0 | 0 | rs | | | | | 0 | 0 | 0 | 0 | 0
二进制（低位） | 15 | 14 | 13 | 12 | 11 | 10 | 9 | 8 | 7 | 6 | 5 | 4 | 3 | 2 | 1 | 0
| rd | | | | | 0 | 0 | 0 | 0 | 0 | 0 | 0 | 1 | 0 | 0 | 1
MIPS语言 | JALR rs rd
指令功能 | PC ⇐ R[s], R[d] ⇐ RPC
功能说明 | 无条件跳转目的寄存器rs中所存地址执行，将延时槽后一条指令存入R[d]
二进制（高位） | 31 | 30 | 29 | 28 | 27 | 26 | 25 | 24 | 23 | 22 | 21 | 20 | 19 | 18 | 17 | 16
| 0 | 0 | 0 | 0 | 0 | 0 | rs | | | | | 0 | 0 | 0 | 0 | 0
二进制（低位） | 15 | 14 | 13 | 12 | 11 | 10 | 9 | 8 | 7 | 6 | 5 | 4 | 3 | 2 | 1 | 0
| 0 | 0 | 0 | 0 | 0 | 0 | 0 | 0 | 0 | 0 | 0 | 0 | 1 | 0 | 0 | 0
MIPS语言 | JR rs
指令功能 | PC ⇐ R[s]
功能说明 | 无条件跳转至寄存器rs所存地址执行
二进制（高位） | 31 | 30 | 29 | 28 | 27 | 26 | 25 | 24 | 23 | 22 | 21 | 20 | 19 | 18 | 17 | 16
| 1 | 0 | 0 | 0 | 1 | 1 | rs | | | | | rt
二进制（低位） | 15 | 14 | 13 | 12 | 11 | 10 | 9 | 8 | 7 | 6 | 5 | 4 | 3 | 2 | 1 | 0

immediate
MIPS语言 | LW rt rs immediate
指令功能 | R[t] ⇐ MEM[R[s] + Sign-extend(immediate)]
功能说明 | 将寄存器rs的值与立即数immediate符号扩展后相加所得存至rt中
二进制（高位） | 31 | 30 | 29 | 28 | 27 | 26 | 25 | 24 | 23 | 22 | 21 | 20 | 19 | 18 | 17 | 16
| 1 | 0 | 1 | 0 | 1 | 1 | rs | | | | | rt
二进制（低位） | 15 | 14 | 13 | 12 | 11 | 10 | 9 | 8 | 7 | 6 | 5 | 4 | 3 | 2 | 1 | 0

immediate
MIPS语言 | SW rt rs immediate
指令功能 | MEM[R[s] + Sign-extend(immediate)] ⇐ R[t]
功能说明 | 将寄存器rt的值存入寄存器rs的值与立即数immediate符号扩展后相加所得地 址中

二进制（高位） | 31 | 30 | 29 | 28 | 27 | 26 | 25 | 24 | 23 | 22 | 21 | 20 | 19 | 18 | 17 | 16
| 1 | 0 | 0 | 0 | 0 | 0 | rs | | | | | rt
二进制（低位） | 15 | 14 | 13 | 12 | 11 | 10 | 9 | 8 | 7 | 6 | 5 | 4 | 3 | 2 | 1 | 0

immediate
MIPS语言 | LB rt rs immediate
指令功能 | R[t] ⇐ Sign-extend(MEM Byte[R[s] + Sign-extend(immediate)])
功能说明 | 将寄存器rs的值与立即数immediate符号扩展后相加所得地址中第一个字节取 出来符号扩展后保存在寄存器rt中
二进制（高位） | 31 | 30 | 29 | 28 | 27 | 26 | 25 | 24 | 23 | 22 | 21 | 20 | 19 | 18 | 17 | 16
| 1 | 0 | 0 | 1 | 0 | 0 | rs | | | | | rt
二进制（低位） | 15 | 14 | 13 | 12 | 11 | 10 | 9 | 8 | 7 | 6 | 5 | 4 | 3 | 2 | 1 | 0

immediate
MIPS语言 | LBU rt rs immediate
指令功能 | R[t] ⇐ Zero-extend(MEM Byte[R[s] + Sign-extend(immeidate)])
功能说明 | 将寄存器rs的值与立即数immediate符号扩展后相加所得地址中的第一个字节 取出来零扩展后保存在寄存器rt中
二进制（高位） | 31 | 30 | 29 | 28 | 27 | 26 | 25 | 24 | 23 | 22 | 21 | 20 | 19 | 18 | 17 | 16
| 1 | 0 | 1 | 0 | 0 | 0 | rs | | | | | rt
二进制（低位） | 15 | 14 | 13 | 12 | 11 | 10 | 9 | 8 | 7 | 6 | 5 | 4 | 3 | 2 | 1 | 0

immediate
MIPS语言 | SB rt rs immediate
指令功能 | MEM Byte[R[s] + Sign-extend(immediate) ⇐ LOW BYTE[R[t]]
功能说明 | 将寄存器rt的最低字节取出来保存在rs的值与立即数immediate符号扩展后相加 所得地址中
二进制（高位） | 31 | 30 | 29 | 28 | 27 | 26 | 25 | 24 | 23 | 22 | 21 | 20 | 19 | 18 | 17 | 16
| 0 | 0 | 0 | 0 | 0 | 0 | rs | | | | | rt
二进制（低位） | 15 | 14 | 13 | 12 | 11 | 10 | 9 | 8 | 7 | 6 | 5 | 4 | 3 | 2 | 1 | 0
| rd | | | | | 0 | 0 | 0 | 0 | 0 | 1 | 0 | 0 | 1 | 0 | 0
MIPS语言 | AND rd rs rt
指令功能 | R[d] ⇐ R[s] & R[t]
功能说明 | 将寄存器rs与寄存器rt的值相与后的结果保存至寄存器rd中

二进制（高位） | 31 | 30 | 29 | 28 | 27 | 26 | 25 | 24 | 23 | 22 | 21 | 20 | 19 | 18 | 17 | 16
| 0 | 0 | 1 | 1 | 0 | 0 | rs | | | | | rt
二进制（低位） | 15 | 14 | 13 | 12 | 11 | 10 | 9 | 8 | 7 | 6 | 5 | 4 | 3 | 2 | 1 | 0

immediate
MIPS语言 | ANDI rt rs immediate
指令功能 | R[t] ⇐ R[s] & Zero-extend(immediate)
功能说明 | 将寄存器rs的值与立即数零扩展后相与的结果保存至寄存器rt中
二进制（高位） | 31 | 30 | 29 | 28 | 27 | 26 | 25 | 24 | 23 | 22 | 21 | 20 | 19 | 18 | 17 | 16
| 0 | 0 | 1 | 1 | 1 | 1 | 0 | 0 | 0 | 0 | 0 | rt
二进制（低位） | 15 | 14 | 13 | 12 | 11 | 10 | 9 | 8 | 7 | 6 | 5 | 4 | 3 | 2 | 1 | 0

immediate
MIPS语言 | LUI rt immediate
指令功能 | R[t] ⇐ immediate * 65536
功能说明 | 将16为立即数放至寄存器rt的高16位中
二进制（高位） | 31 | 30 | 29 | 28 | 27 | 26 | 25 | 24 | 23 | 22 | 21 | 20 | 19 | 18 | 17 | 16
| 0 | 0 | 0 | 0 | 0 | 0 | rs | | | | | rt
二进制（低位） | 15 | 14 | 13 | 12 | 11 | 10 | 9 | 8 | 7 | 6 | 5 | 4 | 3 | 2 | 1 | 0
| rd | | | | | 0 | 0 | 0 | 0 | 0 | 1 | 0 | 0 | 1 | 1 | 1
MIPS语言 | NOR rd rs rt
指令功能 | R[d] ⇐ ∼(R[s] | R[t])
功能说明 | 将寄存器rs与寄存器rt的值或非后的结果保存至寄存器rd中
二进制（高位） | 31 | 30 | 29 | 28 | 27 | 26 | 25 | 24 | 23 | 22 | 21 | 20 | 19 | 18 | 17 | 16
| 0 | 0 | 0 | 0 | 0 | 0 | rs | | | | | rt
二进制（低位） | 15 | 14 | 13 | 12 | 11 | 10 | 9 | 8 | 7 | 6 | 5 | 4 | 3 | 2 | 1 | 0
| rd | | | | | 0 | 0 | 0 | 0 | 0 | 1 | 0 | 0 | 1 | 0 | 1
MIPS语言 | OR rd rs rt
指令功能 | R[d] ⇐ R[s] | R[t]
功能说明 | 将寄存器rs与寄存器rt的值相或后的结果保存至寄存器rd中

二进制（高位） | 31 | 30 | 29 | 28 | 27 | 26 | 25 | 24 | 23 | 22 | 21 | 20 | 19 | 18 | 17 | 16
| 0 | 0 | 1 | 1 | 0 | 1 | rs | | | | | rt
二进制（低位） | 15 | 14 | 13 | 12 | 11 | 10 | 9 | 8 | 7 | 6 | 5 | 4 | 3 | 2 | 1 | 0

immediate
MIPS语言 | ORI rt rs immediate
指令功能 | R[t] ⇐ R[s] | Zero-extend(immediate)
功能说明 | 将寄存器rs与立即数immediate零扩展后相或的结果保存至寄存器rd中
二进制（高位） | 31 | 30 | 29 | 28 | 27 | 26 | 25 | 24 | 23 | 22 | 21 | 20 | 19 | 18 | 17 | 16
| 0 | 0 | 0 | 0 | 0 | 0 | rs | | | | | rt
二进制（低位） | 15 | 14 | 13 | 12 | 11 | 10 | 9 | 8 | 7 | 6 | 5 | 4 | 3 | 2 | 1 | 0
| rd | | | | | 0 | 0 | 0 | 0 | 0 | 1 | 0 | 0 | 1 | 1 | 0
MIPS语言 | XOR rd rs rt
指令功能 | R[d] ⇐ R[s] ∧ R[t]
功能说明 | 将寄存器rs与寄存器rt的值异或后的结果保存至寄存器rd中
二进制（高位） | 31 | 30 | 29 | 28 | 27 | 26 | 25 | 24 | 23 | 22 | 21 | 20 | 19 | 18 | 17 | 16
| 0 | 0 | 1 | 1 | 1 | 0 | rs | | | | | rt
二进制（低位） | 15 | 14 | 13 | 12 | 11 | 10 | 9 | 8 | 7 | 6 | 5 | 4 | 3 | 2 | 1 | 0

immediate
MIPS语言 | XORI rt rs immeidate
指令功能 | R[t] ⇐ R[s] ∧ Zero-extend(immediate)
功能说明 | 将寄存器rs与立即数immediate零扩展后相异或的结果保存至寄存器rd中
二进制（高位） | 31 | 30 | 29 | 28 | 27 | 26 | 25 | 24 | 23 | 22 | 21 | 20 | 19 | 18 | 17 | 16
| 0 | 0 | 0 | 0 | 0 | 0 | 0 | 0 | 0 | 0 | 0 | rt
二进制（低位） | 15 | 14 | 13 | 12 | 11 | 10 | 9 | 8 | 7 | 6 | 5 | 4 | 3 | 2 | 1 | 0
| rd | | | | | immediate | | | | | 0 | 0 | 0 | 0 | 0 | 0
MIPS语言 | SLL rd rt immediate
指令功能 | R[d] ⇐ R[t] immediate
功能说明 | 将寄存器rt中的值逻辑左移立即数immediate位后的结果保存至寄存器rd中

二进制（高位） | 31 | 30 | 29 | 28 | 27 | 26 | 25 | 24 | 23 | 22 | 21 | 20 | 19 | 18 | 17 | 16
| 0 | 0 | 0 | 0 | 0 | 0 | rs | | | | | rt
二进制（低位） | 15 | 14 | 13 | 12 | 11 | 10 | 9 | 8 | 7 | 6 | 5 | 4 | 3 | 2 | 1 | 0
| rd | | | | | 0 | 0 | 0 | 0 | 0 | 0 | 0 | 0 | 1 | 0 | 0
MIPS语言 | SLLV rd rt rs
指令功能 | R[d] ⇐ R[t] R[s]
功能说明 | 将寄存器rt中的值逻辑左移寄存器rs中的值位后的结果保存至寄存器rd中
二进制（高位） | 31 | 30 | 29 | 28 | 27 | 26 | 25 | 24 | 23 | 22 | 21 | 20 | 19 | 18 | 17 | 16
| 0 | 0 | 0 | 0 | 0 | 0 | 0 | 0 | 0 | 0 | 0 | rt
二进制（低位） | 15 | 14 | 13 | 12 | 11 | 10 | 9 | 8 | 7 | 6 | 5 | 4 | 3 | 2 | 1 | 0
| rd | | | | | immediate | | | | | 0 | 0 | 0 | 0 | 1 | 1
MIPS语言 | SRA rd rt immediate
指令功能 | R[d] ⇐ R[t] immediate(arithmetic)
功能说明 | 将寄存器rt中的值算数右移立即数immediate位后的结果保存至寄存器rd中
二进制（高位） | 31 | 30 | 29 | 28 | 27 | 26 | 25 | 24 | 23 | 22 | 21 | 20 | 19 | 18 | 17 | 16
| 0 | 0 | 0 | 0 | 0 | 0 | rs | | | | | rt
二进制（低位） | 15 | 14 | 13 | 12 | 11 | 10 | 9 | 8 | 7 | 6 | 5 | 4 | 3 | 2 | 1 | 0
| rd | | | | | 0 | 0 | 0 | 0 | 0 | 0 | 0 | 0 | 1 | 1 | 1
MIPS语言 | SRAV rd rt rs
指令功能 | R[d] ⇐ R[t] R[s](arithmatic)
功能说明 | 将寄存器rt中的值算数右移寄存器rs中的值位后的结果保存至寄存器rd中
二进制（高位） | 31 | 30 | 29 | 28 | 27 | 26 | 25 | 24 | 23 | 22 | 21 | 20 | 19 | 18 | 17 | 16
| 0 | 0 | 0 | 0 | 0 | 0 | 0 | 0 | 0 | 0 | 0 | rt
二进制（低位） | 15 | 14 | 13 | 12 | 11 | 10 | 9 | 8 | 7 | 6 | 5 | 4 | 3 | 2 | 1 | 0
| rd | | | | | immediate | | | | | 0 | 0 | 0 | 0 | 1 | 0
MIPS语言 | SRL rd rt immediate
指令功能 | R[d] ⇐ R[t] immediate(logical)
功能说明 | 将寄存器rt中的值逻辑右移立即数immediate位后的结果保存至寄存器rd中

二进制（高位） | 31 | 30 | 29 | 28 | 27 | 26 | 25 | 24 | 23 | 22 | 21 | 20 | 19 | 18 | 17 | 16
| 0 | 0 | 0 | 0 | 0 | 0 | rs | | | | | rt
二进制（低位） | 15 | 14 | 13 | 12 | 11 | 10 | 9 | 8 | 7 | 6 | 5 | 4 | 3 | 2 | 1 | 0
| rd | | | | | 0 | 0 | 0 | 0 | 0 | 0 | 0 | 0 | 1 | 1 | 0
MIPS语言 | SRLV rd rt rs
指令功能 | R[d] ⇐ R[t] R[s](logical)
功能说明 | 将寄存器rt中的值逻辑右移寄存器rs中的值位后的结果保存至寄存器rd中
二进制（高位） | 31 | 30 | 29 | 28 | 27 | 26 | 25 | 24 | 23 | 22 | 21 | 20 | 19 | 18 | 17 | 16
| 0 | 0 | 0 | 0 | 0 | 0 | 0 | 0 | 0 | 0 | 0 | 0 | 0 | 0 | 0 | 0
二进制（低位） | 15 | 14 | 13 | 12 | 11 | 10 | 9 | 8 | 7 | 6 | 5 | 4 | 3 | 2 | 1 | 0
| 0 | 0 | 0 | 0 | 0 | 0 | 0 | 0 | 0 | 0 | 0 | 0 | 1 | 1 | 0 | 0
MIPS语言 | SYSCALL
指令功能 | 中断号 ⇐ SYSCALL
功能说明 | 执行后除法中断
二进制（高位） | 31 | 30 | 29 | 28 | 27 | 26 | 25 | 24 | 23 | 22 | 21 | 20 | 19 | 18 | 17 | 16
| 1 | 0 | 1 | 1 | 1 | 1 | rs | | | | | rt
二进制（低位） | 15 | 14 | 13 | 12 | 11 | 10 | 9 | 8 | 7 | 6 | 5 | 4 | 3 | 2 | 1 | 0

immediate
MIPS语言 | CACHE

指令功能

功能说明 | 不做cache，视为NOP
二进制（高位） | 31 | 30 | 29 | 28 | 27 | 26 | 25 | 24 | 23 | 22 | 21 | 20 | 19 | 18 | 17 | 16
| 0 | 1 | 0 | 0 | 0 | 0 | 1 | 0 | 0 | 0 | 0 | 0 | 0 | 0 | 0 | 0
二进制（低位） | 15 | 14 | 13 | 12 | 11 | 10 | 9 | 8 | 7 | 6 | 5 | 4 | 3 | 2 | 1 | 0
| 0 | 0 | 0 | 0 | 0 | 0 | 0 | 0 | 0 | 0 | 0 | 1 | 1 | 0 | 0 | 0
MIPS语言 | ERET
指令功能 | PC ⇐ EPC
功能说明 | 返回至EPC寄存器的地址执行，并设置Status寄存器的EXL位为0

二进制（高位） | 31 | 30 | 29 | 28 | 27 | 26 | 25 | 24 | 23 | 22 | 21 | 20 | 19 | 18 | 17 | 16
| 0 | 1 | 0 | 0 | 0 | 0 | 0 | 0 | 0 | 0 | 0 | rt
二进制（低位） | 15 | 14 | 13 | 12 | 11 | 10 | 9 | 8 | 7 | 6 | 5 | 4 | 3 | 2 | 1 | 0
| rd | | | | | 0 | 0 | 0 | 0 | 0 | 0 | 0 | 0 | 0 | 0 | 0
MIPS语言 | MFC0 rt rd
指令功能 | R[t] ⇐ CP0[R[d]]
功能说明 | 将协处理器0中的rd寄存器的值保存到rt寄存器中
二进制（高位） | 31 | 30 | 29 | 28 | 27 | 26 | 25 | 24 | 23 | 22 | 21 | 20 | 19 | 18 | 17 | 16
| 0 | 1 | 0 | 0 | 0 | 0 | 0 | 0 | 1 | 0 | 0 | rt
二进制（低位） | 15 | 14 | 13 | 12 | 11 | 10 | 9 | 8 | 7 | 6 | 5 | 4 | 3 | 2 | 1 | 0
| rd | | | | | 0 | 0 | 0 | 0 | 0 | 0 | 0 | 0 | 0 | 0 | 0
MIPS语言 | MTC0 rd rt
指令功能 | CP0[R[d]] ⇐ R[t]
功能说明 | 将寄存器rt的值保存到协处理器0中的rd寄存器中
二进制（高位） | 31 | 30 | 29 | 28 | 27 | 26 | 25 | 24 | 23 | 22 | 21 | 20 | 19 | 18 | 17 | 16
| 0 | 1 | 0 | 0 | 0 | 0 | 1 | 0 | 0 | 0 | 0 | 0 | 0 | 0 | 0 | 0
二进制（低位） | 15 | 14 | 13 | 12 | 11 | 10 | 9 | 8 | 7 | 6 | 5 | 4 | 3 | 2 | 1 | 0
| 0 | 0 | 0 | 0 | 0 | 0 | 0 | 0 | 0 | 0 | 0 | 0 | 0 | 0 | 1 | 0
MIPS语言 | TLBWI
指令功能 | R[d] ⇐ R[t] R[s]
功能说明 | 写索引TLB项
二进制（高位） | 31 | 30 | 29 | 28 | 27 | 26 | 25 | 24 | 23 | 22 | 21 | 20 | 19 | 18 | 17 | 16
| 1 | 0 | 0 | 1 | 0 | 1 | rs | | | | | rt
二进制（低位） | 15 | 14 | 13 | 12 | 11 | 10 | 9 | 8 | 7 | 6 | 5 | 4 | 3 | 2 | 1 | 0

immediate
MIPS语言 | LHU rt rs immediate
指令功能 | R[t] ⇐ Zero-extend(MEM HALFWORD[R[s] + Sign-extend(immediate)])
功能说明 | 将寄存器rt中的值与立即数immediate符号扩展后相加所得地址中的低两个 字节取出来零扩展后保存在寄存器rt中
