xwj95/Atom/report/technical/src/img/data_path.png

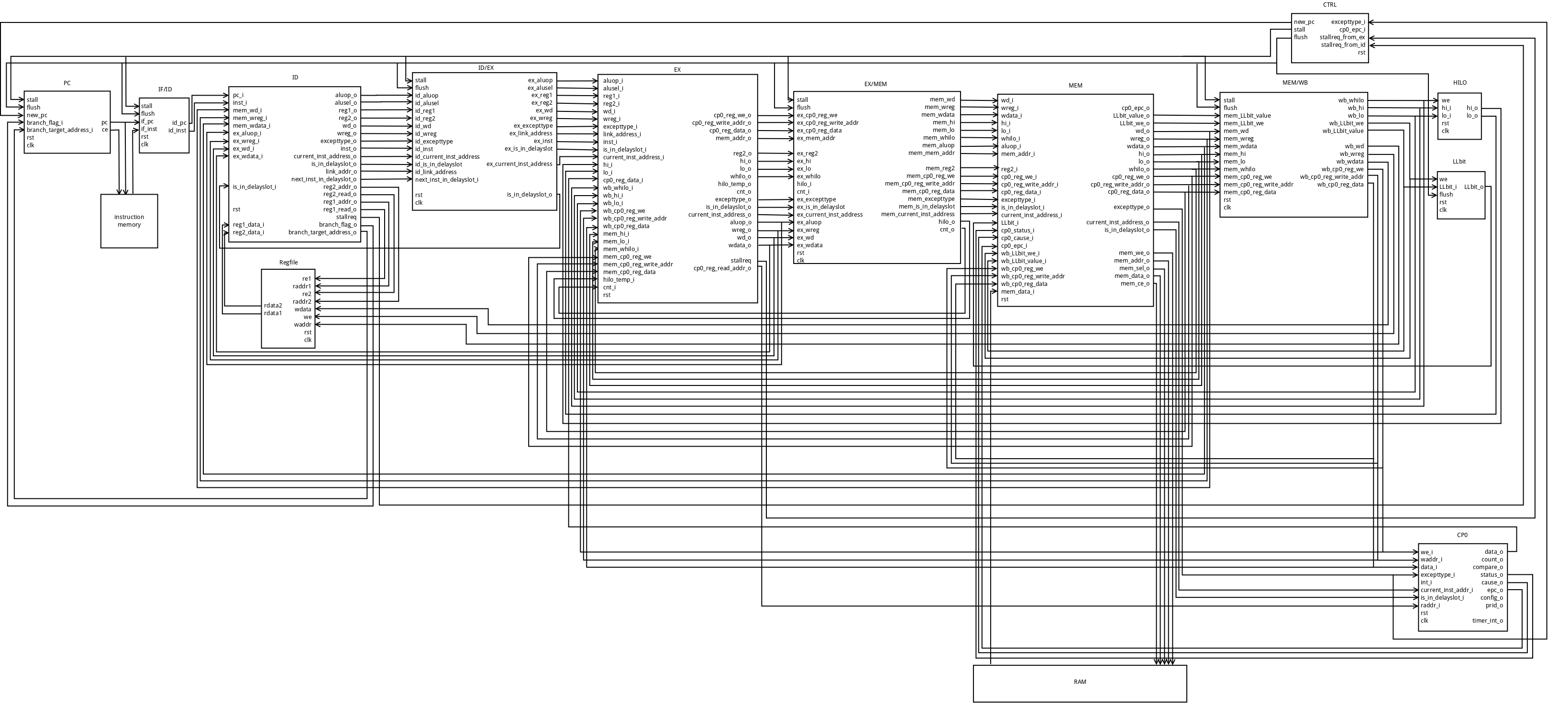
report/technical/src/img/data_path.png
