xwj95/Atom/report/test/src/part1.tex

\newpage
\section{引言}
\subsection{编写目的}

测试是程序开发的一个重要部分。对硬件开发来说，测试的难度比软件开发更高，问题也更隐蔽。其重要性不亚于设计和实现部分。因此书写本测试文档，意在列出测试需求并设计测试样例，对结果进行整理和汇总，并记录这其中遇见的问题。

\subsection{测试方案}

本项目的测试需求为从小到大，从局部到整体，从单指令到多指令，直到最后能跑起操作系统。总体测试设计如下：

\begin{enumerate}

\item 单元测试

\item 指令片段测试

\item 冲突测试

\item 系统测试

\end{enumerate}

说明：

在测试过程中，若无特殊说明，均为将时钟接入单步时钟进行调试。通过32个拨码开关来选择此时想查看的变量， 并通过16个LED灯查看结果。为了能够使16位灯显示32位结果，我们在拨码开关上留下一位用于控制LED灯显示为高16位还是低16位。
\newpage
