xwj95/Atom/report/test/src/renew.tex

\renewcommand{\abstractname}{摘 \qquad 要}
\renewcommand{\contentsname}{\center 目\qquad\qquad录}
\renewcommand{\listfigurename}{图 \quad 示 \quad 目 \quad 录}
\renewcommand{\listtablename}{表 \quad 格 \quad 目 \quad 录}
\renewcommand{\appendixname}{附录}
\renewcommand{\refname}{\center 参 \quad 考 \quad 文 \quad 献}
\renewcommand{\indexname}{\center 索 \qquad 引}
\renewcommand{\figurename}{图}
\renewcommand{\tablename}{表}
