xwj95/Atom/fpga/fpga2ram/input.v

32'h00000000: begin bus_data_i <= 32'h00000000; bus_addr_i <= {12'b0, pc[19:0]}; pc <= pc + 1'b1; end
32'h00000001: begin bus_data_i <= 32'h3c01be00; bus_addr_i <= {12'b0, pc[19:0]}; pc <= pc + 1'b1; end
32'h00000002: begin bus_data_i <= 32'h3c028000; bus_addr_i <= {12'b0, pc[19:0]}; pc <= pc + 1'b1; end
32'h00000003: begin bus_data_i <= 32'h34420100; bus_addr_i <= {12'b0, pc[19:0]}; pc <= pc + 1'b1; end
32'h00000004: begin bus_data_i <= 32'h3c05be00; bus_addr_i <= {12'b0, pc[19:0]}; pc <= pc + 1'b1; end
32'h00000005: begin bus_data_i <= 32'h34a51000; bus_addr_i <= {12'b0, pc[19:0]}; pc <= pc + 1'b1; end
32'h00000006: begin bus_data_i <= 32'h08000008; bus_addr_i <= {12'b0, pc[19:0]}; pc <= pc + 1'b1; end
32'h00000007: begin bus_data_i <= 32'h00000000; bus_addr_i <= {12'b0, pc[19:0]}; pc <= pc + 1'b1; end
32'h00000008: begin bus_data_i <= 32'h8c230000; bus_addr_i <= {12'b0, pc[19:0]}; pc <= pc + 1'b1; end
32'h00000009: begin bus_data_i <= 32'hac430000; bus_addr_i <= {12'b0, pc[19:0]}; pc <= pc + 1'b1; end
32'h0000000a: begin bus_data_i <= 32'h8c440000; bus_addr_i <= {12'b0, pc[19:0]}; pc <= pc + 1'b1; end
32'h0000000b: begin bus_data_i <= 32'h24210004; bus_addr_i <= {12'b0, pc[19:0]}; pc <= pc + 1'b1; end
32'h0000000c: begin bus_data_i <= 32'h24420004; bus_addr_i <= {12'b0, pc[19:0]}; pc <= pc + 1'b1; end
32'h0000000d: begin bus_data_i <= 32'h10250003; bus_addr_i <= {12'b0, pc[19:0]}; pc <= pc + 1'b1; end
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
32'h00000072: begin bus_data_i <= 32'h00000000; bus_addr_i <= {12'b0, pc[19:0]}; pc <= pc + 1'b1; end
32'h00000073: begin bus_data_i <= 32'h00000000; bus_addr_i <= {12'b0, pc[19:0]}; pc <= pc + 1'b1; end
32'h00000074: begin bus_data_i <= 32'h00000000; bus_addr_i <= {12'b0, pc[19:0]}; pc <= pc + 1'b1; end
32'h00000075: begin bus_data_i <= 32'h00000000; bus_addr_i <= {12'b0, pc[19:0]}; pc <= pc + 1'b1; end
32'h00000076: begin bus_data_i <= 32'h00000000; bus_addr_i <= {12'b0, pc[19:0]}; pc <= pc + 1'b1; end
