xwj95/Atom/fpga/com2flash/com2flash.v

module com2flash
	#(parameter FLASH_ADDR_SIZE = 22)
	(
	input clk,
	input rst,
	output [15:0] led,
	output [0:6] segdisp0,
	output [0:6] segdisp1,
	output [FLASH_ADDR_SIZE:0] flash_addr,
	inout [15:0] flash_data,
	output [7:0] flash_ctl,
	output com_TxD,
	input com_RxD);

	localparam
		CMD_WRITE	= 8'b11110000,
		CMD_READ	= 8'b00001111,
		CMD_ERASE	= 8'b00111000,
		CMD_ERASE_IN_PROGRESS	= 8'b11001100,
		CMD_ERASE_FINISHED		= 8'b00110011;
				

	wire [7:0] data_from_com;
	reg uart_TxD_start;
	wire uart_TxD_busy, uart_RxD_data_ready, uart_rst;

	reg [19:0] frame_cnt;
	reg [3:0] frame_looper;

	// display number of 4k blocks
	digseg_driver disp_fc_high(.data(frame_cnt[19:16]), .seg(segdisp1));
	digseg_driver disp_fc_low(.data(frame_cnt[15:12]), .seg(segdisp0));

	assign uart_rst = ~rst;

	reg [7:0] data_to_com, data_to_com_cache;

	uart uart_inst(.clk(clk), .rst(uart_rst), .data_in(data_to_com),
		.data_out(data_from_com), .TxD_start(uart_TxD_start),
		.TxD_busy(uart_TxD_busy), .RxD_data_ready(uart_RxD_data_ready),
		.com_TxD(com_TxD), .com_RxD(com_RxD));

	reg [7:0] checksum;
	reg [FLASH_ADDR_SIZE-1:0] start_addr, end_addr, addr_to_flash;
	wire [FLASH_ADDR_SIZE-1:0] start_addr_next = start_addr + 1'b1;

	reg [47:0] comdata_shift;
	reg [2:0] comdata_shift_cnt;
	wire [2:0] comdata_shift_cnt_next = comdata_shift_cnt + 1'b1;

	wire [7:0] checksum_init = 8'h23;

	wire flash_busy;
	wire [15:0] data_from_flash;
	reg enable_flash_write = 0,
		enable_flash_read = 0,
		enable_flash_erase = 0;

	flash_driver flash_driver_inst(
		.clk(~clk),	// invert clock to ensuare stable signal on rising edge
		.addr(addr_to_flash),
		.data_in(comdata_shift[15:0]), .data_out(data_from_flash),
		.enable_read(enable_flash_read),
		.enable_write(enable_flash_write),
		.enable_erase(enable_flash_erase),
		.busy(flash_busy),
		.flash_addr(flash_addr), .flash_data(flash_data),
		.flash_ctl(flash_ctl));

	localparam
		IDLE = 4'b0000,
		RECV_META = 4'b0001,
		META_ACK = 4'b0011,
		WRITE_INIT_TRANSFER = 4'b0010,
		WRITE_RECV_DATA = 4'b0110,
		WRITE_SEND_DATA_ACK = 4'b0111,
		READ_INIT_TRANSFER = 4'b0101,
		READ_READ_FLASH = 4'b0100,
		READ_SEND_HIGH = 4'b1100,
		READ_SEND_LOW = 4'b1101,
		ERASE_START = 4'b1111,
		ERASE_WAIT = 4'b1110,
		WAITING_UART_SEND = 4'b1010,
		WAITING_UART_SEND_1 = 4'b1011,
		ERROR = 4'b1001;

	reg [3:0] state = IDLE, state_after_meta_ack, state_after_uart_sent;

	reg err_flash_too_slow = 0;

	assign led = {state, frame_looper,
		1'b0, err_flash_too_slow, 
		uart_TxD_busy, uart_RxD_data_ready,
		enable_flash_erase, enable_flash_read, enable_flash_write,
		flash_busy};

	always @(posedge clk) begin
		if (~rst) begin
			frame_cnt <= 0;
			frame_looper <= 0;
		end
		else if (uart_RxD_data_ready) begin
			comdata_shift <= {comdata_shift[39:0], data_from_com};
			frame_cnt <= frame_cnt + 1'b1;
			frame_looper <= {frame_looper[2:0], !frame_looper[2:0]};
		end
	end

	always @(posedge clk) begin
		if (!rst)
			state <= IDLE;
		else case (state)
			IDLE: begin
				uart_TxD_start <= 0;
				checksum <= checksum_init;
				comdata_shift_cnt <= 0;
				enable_flash_write <= 0;
				enable_flash_read <= 0;
				enable_flash_erase <= 0;
				if (uart_RxD_data_ready) begin
					if (data_from_com == CMD_WRITE) begin
						state <= RECV_META;
						state_after_meta_ack <= WRITE_INIT_TRANSFER;
					end else if (data_from_com == CMD_READ) begin
						state <= RECV_META;
						state_after_meta_ack <= READ_INIT_TRANSFER;
					end else if (data_from_com == CMD_ERASE) begin
						state <= RECV_META;
						state_after_meta_ack <= ERASE_START;
					end
				end
			end

			RECV_META:
				if (uart_RxD_data_ready) begin
					comdata_shift_cnt <= comdata_shift_cnt_next;
					checksum <= checksum ^ data_from_com;
					if (comdata_shift_cnt_next == 6)
						state <= META_ACK;
				end
			META_ACK: begin
				start_addr <= comdata_shift[FLASH_ADDR_SIZE-1+24:24];
				end_addr <= comdata_shift[FLASH_ADDR_SIZE-1:0];
				data_to_com <= checksum;
				uart_TxD_start <= 1;
				checksum <= checksum_init;
				state <= WAITING_UART_SEND;
				state_after_uart_sent <= state_after_meta_ack;
			end

			WRITE_INIT_TRANSFER: begin
				uart_TxD_start <= 0;
				comdata_shift_cnt[0] <= 0;
				state <= WRITE_RECV_DATA;
			end
			WRITE_RECV_DATA: begin
				if (uart_RxD_data_ready) begin
					if (flash_busy) begin
						state <= ERROR;
						err_flash_too_slow <= 1;
					end
					comdata_shift_cnt[0] <= comdata_shift_cnt_next[0];
					enable_flash_write <= comdata_shift_cnt[0]; 
					if (comdata_shift_cnt[0]) begin
						addr_to_flash <= start_addr;
						checksum <= checksum ^ data_from_com ^
							comdata_shift[7:0];

						if (start_addr_next == end_addr)
							state <= WRITE_SEND_DATA_ACK;
						start_addr <= start_addr_next;
					end 
				end else
					enable_flash_write <= 0;
			end
			WRITE_SEND_DATA_ACK: begin
				enable_flash_write <= 0;
				if (!flash_busy) begin
					data_to_com <= checksum;
					uart_TxD_start <= 1;
					state_after_uart_sent <= IDLE;
					state <= WAITING_UART_SEND;
				end
			end

			READ_INIT_TRANSFER: begin
				uart_TxD_start <= 0;
				addr_to_flash <= start_addr;
				enable_flash_read <= 1;
				state <= READ_READ_FLASH;
			end
			READ_READ_FLASH: begin
				if (!flash_busy) begin
					checksum <= checksum ^ 
						data_from_flash[15:8] ^ data_from_flash[7:0];
					data_to_com <= data_from_flash[15:8];
					data_to_com_cache <= data_from_flash[7:0];
					uart_TxD_start <= 1;
					state_after_uart_sent <= READ_SEND_HIGH;
					state <= WAITING_UART_SEND;
					// parallel loading next word
					start_addr <= start_addr_next; 
					addr_to_flash <= start_addr_next; 
				end
			end
			READ_SEND_HIGH: begin
				data_to_com <= data_to_com_cache;
				uart_TxD_start <= 1;
				state_after_uart_sent <= READ_SEND_LOW;
				state <= WAITING_UART_SEND;
			end
			READ_SEND_LOW: begin
				if (start_addr == end_addr) begin
					uart_TxD_start <= 1;
					data_to_com <= checksum;
					state_after_uart_sent <= IDLE;
					state <= WAITING_UART_SEND;
				end else
					state <= READ_READ_FLASH;
			end

			ERASE_START: begin
				enable_flash_erase <= 1;
				addr_to_flash <= start_addr;
				state <= ERASE_WAIT;
			end
			ERASE_WAIT: begin
				uart_TxD_start <= 1;
				enable_flash_erase <= 0;
				if (flash_busy) begin
					data_to_com <= CMD_ERASE_IN_PROGRESS;
					state <= WAITING_UART_SEND;
					state_after_uart_sent <= ERASE_WAIT;
				end else begin
					data_to_com <= CMD_ERASE_FINISHED;
					state <= WAITING_UART_SEND;
					state_after_uart_sent <= IDLE;
				end
			end

			WAITING_UART_SEND:
				if (uart_TxD_busy) begin
					state <= WAITING_UART_SEND_1;
					uart_TxD_start <= 0;
				end
			WAITING_UART_SEND_1: begin
				if (~uart_TxD_busy)
					state <= state_after_uart_sent;
			end

			ERROR:
				state <= ERROR;	// loop forever

			default:
				state <= IDLE;
		endcase
	end

endmodule
