xwj95/Atom/final/rom_inst.v

case (addr)
0: inst <= 32'h3c10be00;
4: inst <= 32'h3c04bfd0;
8: inst <= 32'h34840400;
12: inst <= 32'h240200ff;
16: inst <= 32'hae020000;
20: inst <= 32'h240f0000;
24: inst <= 32'h020f7821;
28: inst <= 32'h8de90000;
32: inst <= 32'h8def0004;
36: inst <= 32'h000f7c00;
40: inst <= 32'h012f4825;
44: inst <= 32'h3c08464c;
48: inst <= 32'h3508457f;
52: inst <= 32'h11090003;
56: inst <= 32'h00000000;
60: inst <= 32'h10000046;
64: inst <= 32'h00000000;
68: inst <= 32'h240f0038;
72: inst <= 32'h020f7821;
76: inst <= 32'h8df10000;
80: inst <= 32'h8def0004;
84: inst <= 32'h000f7c00;
88: inst <= 32'h022f8825;
92: inst <= 32'h240f0058;
96: inst <= 32'h020f7821;
100: inst <= 32'h8df20000;
104: inst <= 32'h8def0004;
108: inst <= 32'h000f7c00;
112: inst <= 32'h024f9025;
116: inst <= 32'h3252ffff;
120: inst <= 32'h240f0030;
124: inst <= 32'h020f7821;
128: inst <= 32'h8df30000;
132: inst <= 32'h8def0004;
136: inst <= 32'h000f7c00;
140: inst <= 32'h026f9825;
144: inst <= 32'h262f0008;
148: inst <= 32'h000f7840;
152: inst <= 32'h020f7821;
156: inst <= 32'h8df40000;
160: inst <= 32'h8def0004;
164: inst <= 32'h000f7c00;
168: inst <= 32'h028fa025;
172: inst <= 32'h262f0010;
176: inst <= 32'h000f7840;
180: inst <= 32'h020f7821;
184: inst <= 32'h8df50000;
188: inst <= 32'h8def0004;
192: inst <= 32'h000f7c00;
196: inst <= 32'h02afa825;
200: inst <= 32'h262f0004;
204: inst <= 32'h000f7840;
208: inst <= 32'h020f7821;
212: inst <= 32'h8df60000;
216: inst <= 32'h8def0004;
220: inst <= 32'h000f7c00;
224: inst <= 32'h12800011;
228: inst <= 32'h02cfb025;
232: inst <= 32'h12a0000f;
236: inst <= 32'h00000000;
240: inst <= 32'hac960000;
244: inst <= 32'h26cf0000;
248: inst <= 32'h000f7840;
252: inst <= 32'h020f7821;
256: inst <= 32'h8de80000;
260: inst <= 32'h8def0004;
264: inst <= 32'h000f7c00;
268: inst <= 32'h010f4025;
272: inst <= 32'hae880000;
276: inst <= 32'h26d60004;
280: inst <= 32'h26940004;
284: inst <= 32'h26b5fffc;
288: inst <= 32'h1ea0fff3;
292: inst <= 32'h00000000;
296: inst <= 32'h26310020;
300: inst <= 32'h2652ffff;
304: inst <= 32'h1e40ffd7;
308: inst <= 32'h00000000;
312: inst <= 32'h24020023;
316: inst <= 32'h02600008;
320: inst <= 32'hac820000;
324: inst <= 32'h3c04bfd0;
328: inst <= 32'h34840400;
332: inst <= 32'h240200ef;
336: inst <= 32'h1000fffc;
340: inst <= 32'hac820000;
344: inst <= 32'h3c04bfd0;
348: inst <= 32'h34840400;
352: inst <= 32'h240200ee;
356: inst <= 32'h1000fffc;
360: inst <= 32'hac820000;
default: inst <= 0;
endcase
