xwj95/Atom/final/rom_inst_2.v

case (addr)
0: inst <= 32'h3c10be00;
1: inst <= 32'h3c04bfd0;
2: inst <= 32'h34840400;
3: inst <= 32'h00000000;
4: inst <= 32'h00000000;
5: inst <= 32'h240f0000;
6: inst <= 32'h020f7821;
7: inst <= 32'h8de90000;
8: inst <= 32'h8def0004;
9: inst <= 32'h000f7c00;
10: inst <= 32'h012f4825;
11: inst <= 32'h3c08464c;
12: inst <= 32'h3508457f;
13: inst <= 32'h11090003;
14: inst <= 32'h00000000;
15: inst <= 32'h10000046;
16: inst <= 32'h00000000;
17: inst <= 32'h240f0038;
18: inst <= 32'h020f7821;
19: inst <= 32'h8df10000;
20: inst <= 32'h8def0004;
21: inst <= 32'h000f7c00;
22: inst <= 32'h022f8825;
23: inst <= 32'h240f0058;
24: inst <= 32'h020f7821;
25: inst <= 32'h8df20000;
26: inst <= 32'h8def0004;
27: inst <= 32'h000f7c00;
28: inst <= 32'h024f9025;
29: inst <= 32'h3252ffff;
30: inst <= 32'h240f0030;
31: inst <= 32'h020f7821;
32: inst <= 32'h8df30000;
33: inst <= 32'h8def0004;
34: inst <= 32'h000f7c00;
35: inst <= 32'h026f9825;
36: inst <= 32'h262f0008;
37: inst <= 32'h000f7840;
38: inst <= 32'h020f7821;
39: inst <= 32'h8df40000;
40: inst <= 32'h8def0004;
41: inst <= 32'h000f7c00;
42: inst <= 32'h028fa025;
43: inst <= 32'h262f0010;
44: inst <= 32'h000f7840;
45: inst <= 32'h020f7821;
46: inst <= 32'h8df50000;
47: inst <= 32'h8def0004;
48: inst <= 32'h000f7c00;
49: inst <= 32'h02afa825;
50: inst <= 32'h262f0004;
51: inst <= 32'h000f7840;
52: inst <= 32'h020f7821;
53: inst <= 32'h8df60000;
54: inst <= 32'h8def0004;
55: inst <= 32'h000f7c00;
56: inst <= 32'h12800011;
57: inst <= 32'h02cfb025;
58: inst <= 32'h12a0000f;
59: inst <= 32'h00000000;
60: inst <= 32'hac960000;
61: inst <= 32'h26cf0000;
62: inst <= 32'h000f7840;
63: inst <= 32'h020f7821;
64: inst <= 32'h8de80000;
65: inst <= 32'h8def0004;
66: inst <= 32'h000f7c00;
67: inst <= 32'h010f4025;
68: inst <= 32'hae880000;
69: inst <= 32'h26d60004;
70: inst <= 32'h26940004;
71: inst <= 32'h26b5fffc;
72: inst <= 32'h1ea0fff3;
73: inst <= 32'h00000000;
74: inst <= 32'h26310020;
75: inst <= 32'h2652ffff;
76: inst <= 32'h1e40ffd7;
77: inst <= 32'h00000000;
78: inst <= 32'h24020023;
79: inst <= 32'h02600008;
80: inst <= 32'hac820000;
81: inst <= 32'h3c04bfd0;
82: inst <= 32'h34840400;
83: inst <= 32'h240200ef;
84: inst <= 32'h1000fffc;
85: inst <= 32'hac820000;
86: inst <= 32'h3c04bfd0;
87: inst <= 32'h34840400;
88: inst <= 32'h240200ee;
89: inst <= 32'h1000fffc;
90: inst <= 32'hac820000;
default: inst <= 0;
endcase
