xwj95/Atom/OpenMIPS/simulate/input.v

data_mem[0]=32'h00000000;
data_mem[1]=32'h3c01be00;
data_mem[2]=32'h3c028000;
data_mem[3]=32'h34420100;
data_mem[4]=32'h3c05be00;
data_mem[5]=32'h34a51000;
data_mem[6]=32'h08000008;
data_mem[7]=32'h00000000;
data_mem[8]=32'h8c230000;
data_mem[9]=32'hac430000;
data_mem[10]=32'h8c440000;
data_mem[11]=32'h24210004;
data_mem[12]=32'h24420004;
data_mem[13]=32'h10250003;
data_mem[14]=32'h00000000;
data_mem[15]=32'h08000008;
data_mem[16]=32'h00000000;
data_mem[17]=32'h08000011;
data_mem[18]=32'h00000000;
data_mem[19]=32'h00000000;
data_mem[20]=32'h00000000;
data_mem[21]=32'h00000000;
data_mem[22]=32'h00000000;
data_mem[23]=32'h00000000;
data_mem[24]=32'h00000000;
data_mem[25]=32'h00000000;
data_mem[26]=32'h00000000;
data_mem[27]=32'h00000000;
data_mem[28]=32'h00000000;
data_mem[29]=32'h00000000;
data_mem[30]=32'h00000000;
data_mem[31]=32'h00000000;
data_mem[32]=32'h00000000;
data_mem[33]=32'h00000000;
data_mem[34]=32'h00000000;
data_mem[35]=32'h00000000;
data_mem[36]=32'h00000000;
data_mem[37]=32'h00000000;
data_mem[38]=32'h00000000;
data_mem[39]=32'h00000000;
data_mem[40]=32'h00000000;
data_mem[41]=32'h00000000;
data_mem[42]=32'h00000000;
data_mem[43]=32'h00000000;
data_mem[44]=32'h00000000;
data_mem[45]=32'h00000000;
data_mem[46]=32'h00000000;
data_mem[47]=32'h00000000;
data_mem[48]=32'h00000000;
data_mem[49]=32'h00000000;
data_mem[50]=32'h00000000;
data_mem[51]=32'h00000000;
data_mem[52]=32'h00000000;
data_mem[53]=32'h00000000;
data_mem[54]=32'h00000000;
data_mem[55]=32'h00000000;
data_mem[56]=32'h00000000;
data_mem[57]=32'h00000000;
data_mem[58]=32'h00000000;
data_mem[59]=32'h00000000;
data_mem[60]=32'h00000000;
data_mem[61]=32'h00000000;
data_mem[62]=32'h00000000;
data_mem[63]=32'h00000000;
data_mem[64]=32'h00000000;
data_mem[65]=32'h00000000;
data_mem[66]=32'h00000000;
data_mem[67]=32'h00000000;
data_mem[68]=32'h00000000;
data_mem[69]=32'h00000000;
data_mem[70]=32'h00000000;
data_mem[71]=32'h00000000;
data_mem[72]=32'h00000000;
data_mem[73]=32'h00000000;
data_mem[74]=32'h00000000;
data_mem[75]=32'h00000000;
data_mem[76]=32'h00000000;
data_mem[77]=32'h00000000;
data_mem[78]=32'h00000000;
data_mem[79]=32'h00000000;
data_mem[80]=32'h00000000;
data_mem[81]=32'h00000000;
data_mem[82]=32'h00000000;
data_mem[83]=32'h00000000;
data_mem[84]=32'h00000000;
data_mem[85]=32'h00000000;
data_mem[86]=32'h00000000;
data_mem[87]=32'h00000000;
data_mem[88]=32'h00000000;
data_mem[89]=32'h00000000;
data_mem[90]=32'h00000000;
data_mem[91]=32'h00000000;
data_mem[92]=32'h00000000;
data_mem[93]=32'h00000000;
data_mem[94]=32'h00000000;
data_mem[95]=32'h00000000;
data_mem[96]=32'h00000000;
data_mem[97]=32'h00000000;
data_mem[98]=32'h00000000;
data_mem[99]=32'h00000000;
data_mem[100]=32'h00000000;
data_mem[101]=32'h00000000;
data_mem[102]=32'h00000000;
data_mem[103]=32'h00000000;
data_mem[104]=32'h00000000;
data_mem[105]=32'h00000000;
data_mem[106]=32'h00000000;
data_mem[107]=32'h00000000;
data_mem[108]=32'h00000000;
data_mem[109]=32'h00000000;
data_mem[110]=32'h00000000;
data_mem[111]=32'h00000000;
data_mem[112]=32'h00000000;
data_mem[113]=32'h00000000;
data_mem[114]=32'h00000000;
data_mem[115]=32'h00000000;
data_mem[116]=32'h00000000;
data_mem[117]=32'h00000000;
data_mem[118]=32'h00000000;
