xwj95/Atom/OpenMIPS/simulate/work/mem/_primary.vhd

library verilog;
use verilog.vl_types.all;
entity mem is
    port(
        rst             : in     vl_logic;
        wd_i            : in     vl_logic_vector(4 downto 0);
        wreg_i          : in     vl_logic;
        wdata_i         : in     vl_logic_vector(31 downto 0);
        hi_i            : in     vl_logic_vector(31 downto 0);
        lo_i            : in     vl_logic_vector(31 downto 0);
        whilo_i         : in     vl_logic;
        aluop_i         : in     vl_logic_vector(7 downto 0);
        mem_addr_i      : in     vl_logic_vector(31 downto 0);
        reg2_i          : in     vl_logic_vector(31 downto 0);
        mem_data_i      : in     vl_logic_vector(31 downto 0);
        cp0_reg_we_i    : in     vl_logic;
        cp0_reg_write_addr_i: in     vl_logic_vector(4 downto 0);
        cp0_reg_data_i  : in     vl_logic_vector(31 downto 0);
        excepttype_i    : in     vl_logic_vector(31 downto 0);
        is_in_delayslot_i: in     vl_logic;
        current_inst_address_i: in     vl_logic_vector(31 downto 0);
        cp0_bad_v_addr_i: in     vl_logic_vector(31 downto 0);
        cp0_status_i    : in     vl_logic_vector(31 downto 0);
        cp0_cause_i     : in     vl_logic_vector(31 downto 0);
        cp0_epc_i       : in     vl_logic_vector(31 downto 0);
        cp0_index_i     : in     vl_logic_vector(31 downto 0);
        cp0_entry_lo0_i : in     vl_logic_vector(31 downto 0);
        cp0_entry_lo1_i : in     vl_logic_vector(31 downto 0);
        cp0_entry_hi_i  : in     vl_logic_vector(31 downto 0);
        wb_cp0_reg_we   : in     vl_logic;
        wb_cp0_reg_write_addr: in     vl_logic_vector(4 downto 0);
        wb_cp0_reg_data : in     vl_logic_vector(31 downto 0);
        excepttype_is_tlbm_i: in     vl_logic;
        excepttype_is_tlbl_i: in     vl_logic;
        excepttype_is_tlbs_i: in     vl_logic;
        wd_o            : out    vl_logic_vector(4 downto 0);
        wreg_o          : out    vl_logic;
        wdata_o         : out    vl_logic_vector(31 downto 0);
        hi_o            : out    vl_logic_vector(31 downto 0);
        lo_o            : out    vl_logic_vector(31 downto 0);
        whilo_o         : out    vl_logic;
        cp0_reg_we_o    : out    vl_logic;
        cp0_reg_write_addr_o: out    vl_logic_vector(4 downto 0);
        cp0_reg_data_o  : out    vl_logic_vector(31 downto 0);
        mem_addr_o      : out    vl_logic_vector(31 downto 0);
        mem_we_o        : out    vl_logic;
        mem_sel_o       : out    vl_logic_vector(3 downto 0);
        mem_data_o      : out    vl_logic_vector(31 downto 0);
        mem_ce_o        : out    vl_logic;
        excepttype_o    : out    vl_logic_vector(31 downto 0);
        cp0_epc_o       : out    vl_logic_vector(31 downto 0);
        is_in_delayslot_o: out    vl_logic;
        current_inst_address_o: out    vl_logic_vector(31 downto 0);
        bad_v_addr_o    : out    vl_logic_vector(31 downto 0);
        tlb_we_o        : out    vl_logic;
        tlb_index_o     : out    vl_logic_vector(3 downto 0);
        tlb_data_o      : out    vl_logic_vector(63 downto 0)
    );
end mem;
