xwj95/Atom/(commit log)

2015-10-17 latex模板
2015-10-18 需求文档模板
2015-10-18 删除错误上传文件
2015-10-18 移除错误上传文件
2015-10-18 修改了指令集表格格式
2015-10-18 修改指令集表格的错别字
2015-10-18 增加了表格行距
2015-10-18 修改表格页面
2015-10-18 修改指令集表格格式
2015-10-18 修改renewcommand
2015-10-18 增加2.2、2.3、2.4内容
2015-10-18 修改指令集表格缩进
2015-10-18 增加乘法器和寄存器堆
2015-10-18 增加超链接包
2015-10-18 增加ALU部分
2015-10-18 修改大小写
2015-10-18 修改title
2015-10-18 修改NOR
2015-10-18 修改tab
2015-10-18 增加cite
2015-10-18 修改串口和网口部分
2015-10-18 增加CP0部分
2015-10-19 解决编译时目录标签乱码问题
2015-10-19 解决目录标签乱码问题用的程序
2015-10-19 修改ALU和乘法器的部分
2015-10-19 解决表格浮动的问题
2015-10-19 增加表格浮动包
2015-10-19 添加了中断异常部分
2015-10-19 完成CP0文字部分
2015-10-19 画了两个表格
2015-10-19 增加了CP0部分的表格
2015-10-19 完成虚拟内存映射部分
2015-10-19 修改表格样式
2015-10-20 需求分析PPTT模板
2015-10-20 增加TLB部分
2015-10-20 增加参考资料
2015-10-20 修改主频目标
2015-10-20 修改运行概述
2015-10-20 增加CPU概述和数据通路部分
2015-10-20 增加数据通路图
2015-10-20 重画了流程图
2015-10-20 把流程图加入文档中
2015-10-21 完整版需求文档第一稿
2015-10-21 修复第二部分流程图位置放置错误和图片遗漏的bug
2015-10-21 修复流程图和数据通路图的bug
2015-10-21 数据通路图
2015-10-21 修改错别字
2015-10-21 改正错别字
2015-10-21 修改表格格式
2015-10-21 需求分析PPT第一稿
2015-10-22 修正错别字
2015-10-29 修改ALU细节
2015-10-30 添加部分CPU的Verilog代码（框架+ORI指令）（未完成）
2015-10-30 添加工程文件
2015-10-30 改正openmips,id,id_ex的语法错误
2015-10-30 提交模拟文件（含源文件）
2015-10-30 添加使用GNU工具链编译MIPS32指令的模块（需要自己配置GNU工具链）
2015-10-30 补充上传之前忘了上传的testbench部分
2015-11-02 添加数据通路图
2015-11-02 修改目录
2015-11-03 修改编译测试样例所需的Makefile并添加使用方法README
2015-11-03 修改testCase文件名
2015-11-03 增加第二个测试样例
2015-11-03 增加设计文档框架
2015-11-03 修正所有代码tab缩进的问题
2015-11-04 删掉放在proj8里的requirement
2015-11-04 将图片文件放在img文件夹中
2015-11-04 添加给设计文档用的pc阶段的eps图片
2015-11-04 添加设计文档用的CPU各个部件的eps图片
2015-11-04 修改第一部分和第二部分，对CPU各部件的描述进行更进一步的阐述
2015-11-04 删除冗余文件
2015-11-04 恢复被删除的文件
2015-11-04 删除README~
2015-11-04 修改第一部分和第二部分，重新生成pdf文件
2015-11-05 修改第一个和第二个测试样例，增加第三个和第四个测试样例
2015-11-05 实现逻辑运算、移位运算和空指令
2015-11-05 实现移动操作指令
2015-11-16 添加算术指令操作、跳转指令、存储加载指令的部分及相关仿真用样例
2015-11-17 添加CP0部分
2015-11-17 划分阶段与功能描述
2015-11-17 修改表格样式错误
2015-11-17 译码阶段详述与举例
2015-11-17 执行阶段详述与举例
2015-11-17 增加异常处理部分，然而仿真结果还是不对T^T
2015-11-17 整体设计ver0
2015-11-17 逻辑、移位操作、空指令、移动操作指令的实现部分
2015-11-18 修改中断部分的bug
2015-11-18 增加时钟中断测试样例
2015-11-18 添加编译过的测试样例
2015-11-19 修改译码阶段立即数扩展的问题
2015-11-19 算数指令操作和流水线暂停机制的设计与实现
2015-11-19 添加测试文档框架
2015-11-19 修改需求文档错别字
2015-11-19 修改sll指令说明的错别字
2015-11-19 转移指令（跳转、分支）、加载存储指令的实现
2015-11-24 添加指令不存在异常、地址不对齐异常、访问不存在的CP0寄存器异常的样例
2015-11-24 添加编译好的测试样例
2015-11-24 清理文件
2015-11-25 添加地址未对齐异常功能
2015-11-25 添加串口实验代码
    [serial_pad.csv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]
2015-11-26 修复地址不对齐异常没有被触发的bug
2015-11-26 修复译码阶段中无效指令和CPU异常的bit写反的bug
2015-11-26 修改测试样例
2015-11-26 正式开始记录测试过程
2015-11-26 烧入CPLD的代码
    [cpld_pad.csv]
2015-11-26 烧入FPGA的示例程序
    [Atom_pad.csv]
2015-11-27 添加ram部件并修改testCase的README
2015-11-27 添加bootasm.S作为测试样例
2015-11-27 删除bootasm.S
2015-11-27 修改文件系统并添加RAM的测试文件
    [serial_pad.csv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]
2015-11-27 修改串口部分代码
    [serial_pad.csv, uart_pad.csv]
2015-11-27 增加测试通过的串口功能
    [uart_pad.csv]
2015-11-28 添加ram
    [ram_test_pad.csv]
2015-11-28 修改ram的频率
2015-11-28 修改ram代码
2015-11-28 修改ram文件
    [ramtest_pad.csv]
2015-11-28 协处理器访问指令、异常相关
2015-11-28 添加修改过的RAM代码
    [ramtest_pad.csv, uart_pad.csv]
2015-11-29 将ram_driver的enable修改为1有效，并确定之后的部件的enable都是1有效
2015-11-29 添加部分flash的代码
2015-11-29 把ram_driver的状态机修改为格雷码
2015-11-29 添加flash剩余代码
    [flash_test_pad.csv]
2015-11-29 添加已测试通过的flash代码
    [flash_test_pad.csv]
2015-11-29 添加com2flash的代码
    [com2flash_pad.csv]
2015-12-01 修改烧入FPGA的代码
    [ram_test_pad.csv, uart_pad.csv]
2015-12-01 增加wisebone总线
2015-12-01 总线接口
2015-12-01 完成MMU和总线接口的代码
2015-12-02 增加部分总线代码
2015-12-02 在src里添加外设部分代码
2015-12-02 添加总线中的ack信号接口，并修改相应的外设代码
2015-12-02 增加访存阶段地址异常时badvaddr寄存器的赋值
2015-12-02 修改bus.v的错误
2015-12-02 修改文件目录
2015-12-02 修改bus.v的错别字
2015-12-02 修改错误的宏定义
2015-12-02 添加bus的测试项目
    [bus_test_pad.csv]
2015-12-02 修改src中的外设以配合bus使用
2015-12-02 新建仿真项目
2015-12-03 完成MMU和TLB，但是还没有进行测试
2015-12-03 添加bus测试文件（已测试通过）
    [bus_test_pad.csv]
2015-12-03 修改OpenMIPS顶层文件
2015-12-03 在src里添加修改后的外设和bus.v
2015-12-03 删掉不需要的总线代码
2015-12-03 修改宏定义文件
2015-12-03 修改bug
2015-12-03 修改MMU代码bug
2015-12-03 修改TLB代码bug
2015-12-03 添加准备上电路板测试的OpenMIPS项目
    [Atom_pad.csv]
2015-12-03 添加测试通过的bus代码
2015-12-03 删掉刚才错误添加的文件
2015-12-03 优化代码结构
    [openmips_min_sopc_pad.csv]
2015-12-04 添加bus部分代码
2015-12-04 初始化提交
    [cpld_pad.csv]
2015-12-04 修改总线部分代码
2015-12-04 优化代码
2015-12-04 添加修改后的总线代码（未完成）
2015-12-04 修改总线（未完）
2015-12-04 添加修改后的bus代码（未完成）
    [bus_test_pad.csv]
2015-12-04 修改总线的bug
    [bus_test_pad.csv]
2015-12-04 修改总线的bug，发现是ram.v实例化接口变量名写错了
2015-12-04 添加测试通过的总线代码
    [bus_test_pad.csv]
2015-12-04 添加新鞋的部分到stash中
2015-12-05 CPU与总线连接完成
    [openmips_min_sopc_pad.csv]
2015-12-05 添加fpga2ram，实现往RAM中写指令的功能
2015-12-05 25MHz时钟频率的CPU
    [openmips_min_sopc_pad.csv]
2015-12-06 添加src/OpenMIPD
    [cpu_top_pad.csv]
2015-12-06 目前LED灯不亮，不能显示PC值或者寄存器值
    [cpu_top_pad.csv, fpga2ram_pad.csv, openmips_min_sopc_pad.csv]
2015-12-06 修改OpenMIPS里的ram周期
2015-12-07 将总线上的ram读周期修改为1
    [bus_test_pad.csv]
2015-12-07 将总线中的ram写周期改变为2
    [bus_test_pad.csv]
2015-12-07 总线实现flash读写（不支持擦除）
2015-12-07 修改ack接口
2015-12-10 增加LED灯调试
    [cpu_top_pad.csv]
2015-12-10 修改样例1
2015-12-10 添加编译后的测试样例
2015-12-15 添加vga test
    [vga_test_pad.csv]
2015-12-15 ppm2v 图片转换 for vga test
2015-12-16 将所有testCase的第一条指令前面插入一个nop
2015-12-16 添加编译过的测试文件
2015-12-20 添加GPIO测试样例
2016-01-01 需求文档修改完毕
2016-01-01 添加修改后的设计文档
2016-01-02 添加测试文档
    [com2flash_pad.csv, cpu_top_pad.csv, fpga2ram_pad.csv, openmips_min_sopc_pad.csv, uart_pad.csv, vga_test_pad.csv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]
2016-01-02 修改数据通路图
